eSpark-Backup/brianperi-smartwatch/Documents/Client-Files/Concept-Image.JPG

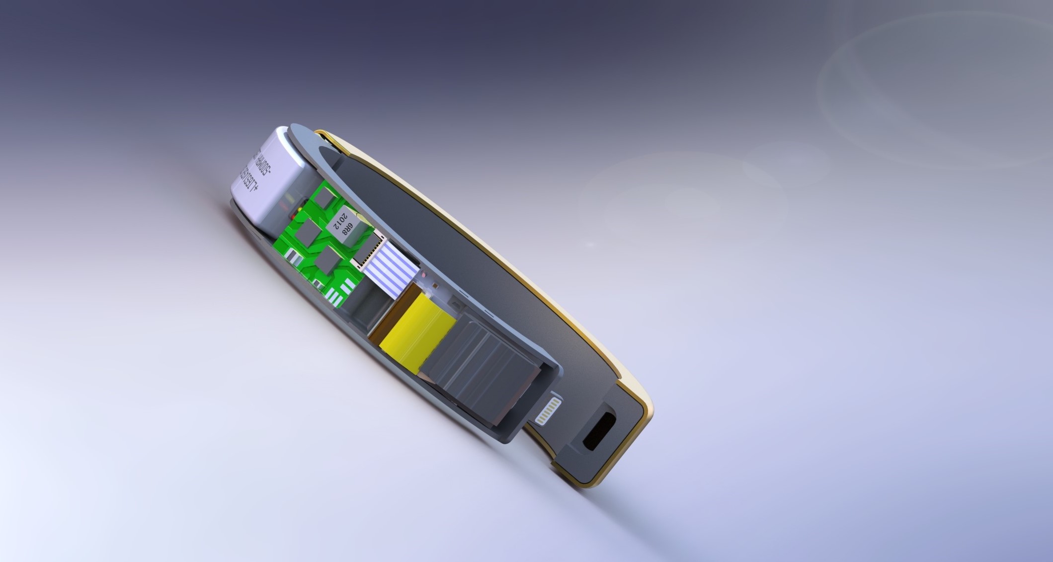
Documents/Client-Files/Concept-Image.JPG
