eSpark-Backup/brianperi-smartwatch/Documents/Client-Files/UPWORK-REQS/v1 pictures/edited/IMG_8461.jpg

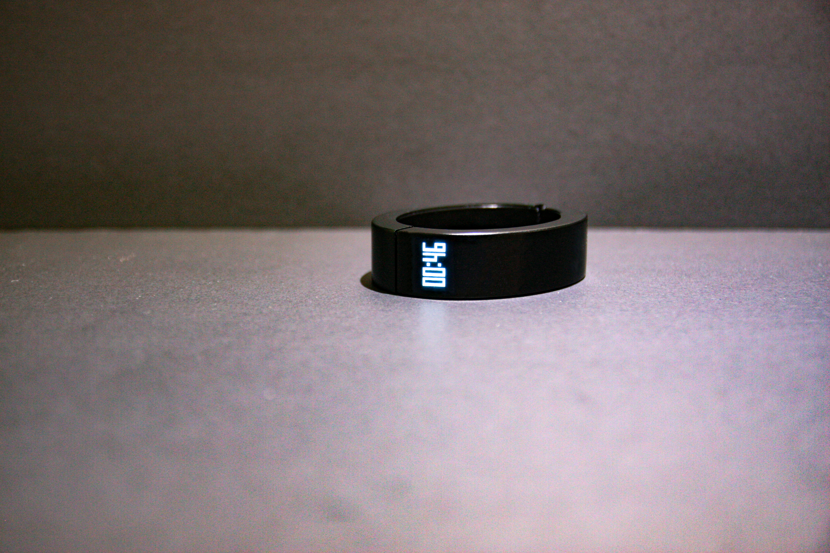
Documents/Client-Files/UPWORK-REQS/v1 pictures/edited/IMG_8461.jpg
