eSpark-Backup/brianperi-smartwatch/README.md

# BrianPeri-SmartWatch
 To enhance existing Smart Watch Design and to add support for BLE / WiFi Capability
