eSpark-Backup/brianperi-smartwatch/Design-Files/Bracelet(Aux_v2.0)/Bracelet_aux.PcbDoc.htm

Reporting Options

# File in Previous Format

Date | : | 7/9/2021
Time | : | 2:30:00 PM
Filename | : | D:\Github\BrianPeri-SmartWatch\Design-Files\Bracelet(Aux_v2.0)\_Design Files\Bracelet_aux.PcbDoc

Version | Warning

This file was generated by an earlier version of the software
