eSpark-Backup/brianperi-smartwatch/Design-Files/Bracelet(Aux_v2.0)/Bracelet_Aux_v2.0.PcbDoc.htm

Reporting Options

# File in Newer Format

Date | : | 7/10/2021
Time | : | 5:29:36 PM
Filename | : | E:\GitHub\BrianPeri-SmartWatch\Design-Files\Bracelet(Aux_v2.0)\_Design Files\Bracelet_Aux_v2.0.PcbDoc

Version | Warning
Release 20.0 | CAUTION - Support of propagation delay for primitives

This file was generated by a later version of the software
