eSpark-Backup/brianperi-smartwatch/Design-Files/Bracelet(Main)/Bracelet_Main.PcbDoc.htm

Reporting Options

# File in Newer Format

Date | : | 7/10/2021
Time | : | 11:03:33 AM
Filename | : | E:\GitHub\BrianPeri-SmartWatch\Design-Files\Bracelet(Main)\_Design Files\Bracelet_Main.PcbDoc

Version | Warning
Release 20.0 | CAUTION - Support of propagation delay for primitives

This file was generated by a later version of the software
