eSpark-Backup/brianperi-smartwatch/Documents/Client-Files/UPWORK-REQS/Concept Pitch2.pptx

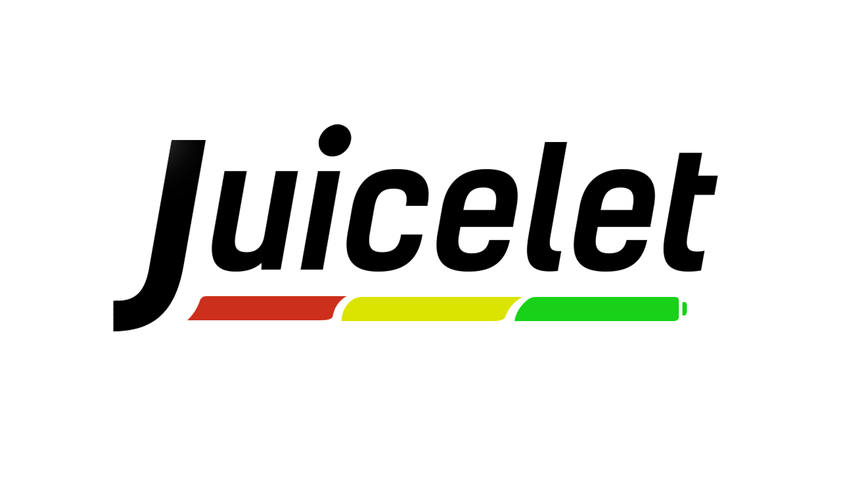
[picture p3: figure]

A whole new way to

c

har

ge.

## Slide 2

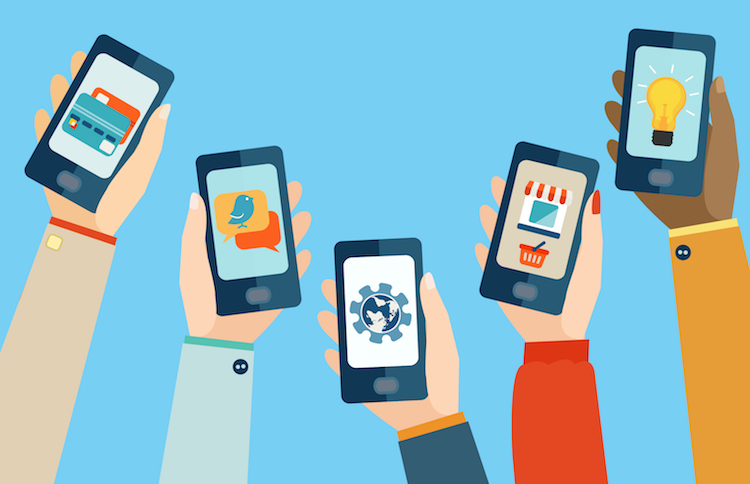
[picture p4: figure]

## Slide 3

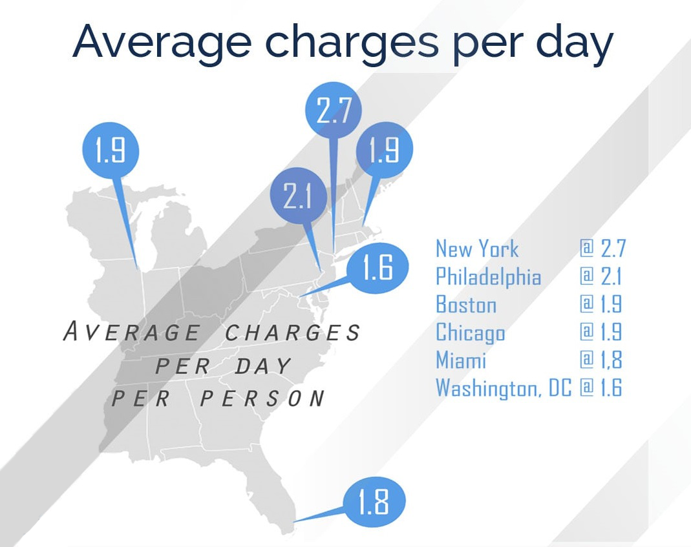
[picture p5: figure]

## 250 cycles

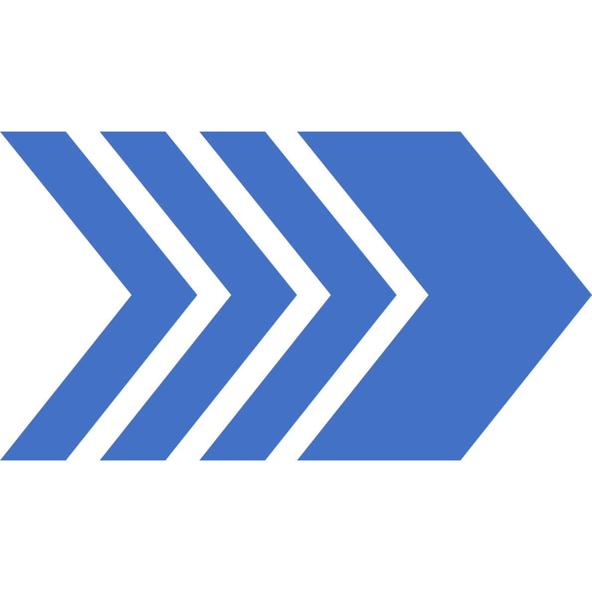
[picture p6: figure]

~73% battery

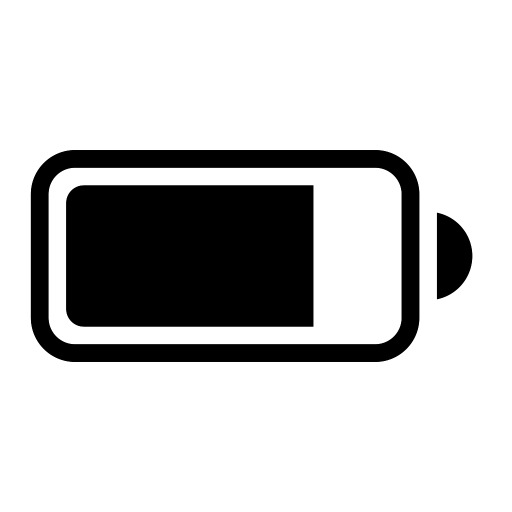
[picture p7: figure]

## Slide 5

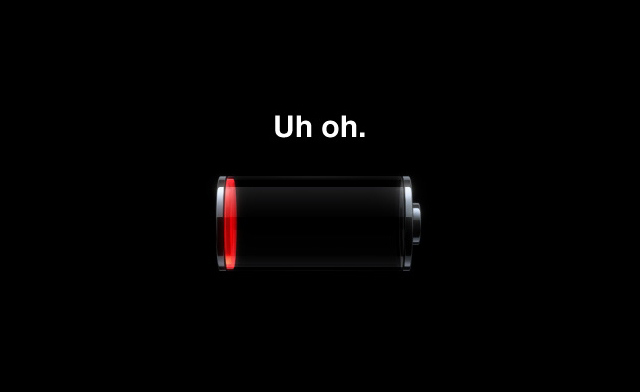
[picture p8: figure]

## Slide 6

Report low battery anxiety,
BUT

7.7 out of 10

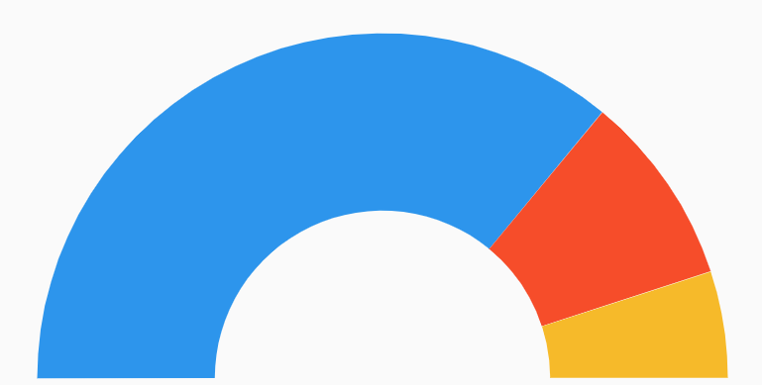
[picture p9: figure]

72%

Carry no backup

18%

Carry a charging cable

10%

Carry a portable charger

## Slide 7

The Problem?

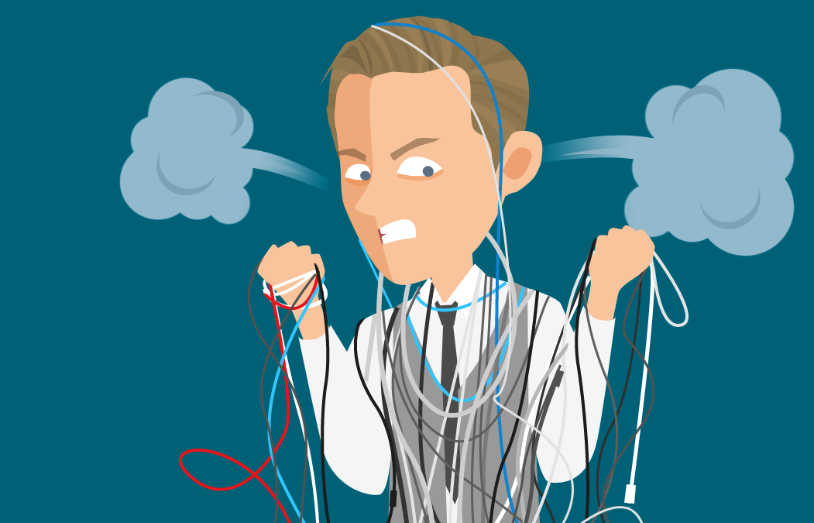
[picture p10: figure]
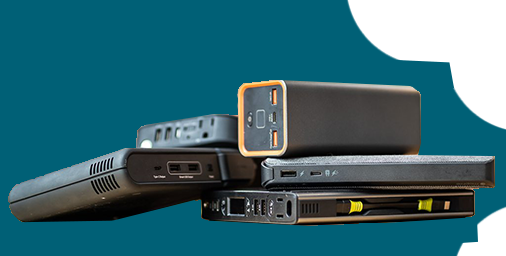
[picture p11: figure]

## Slide 8

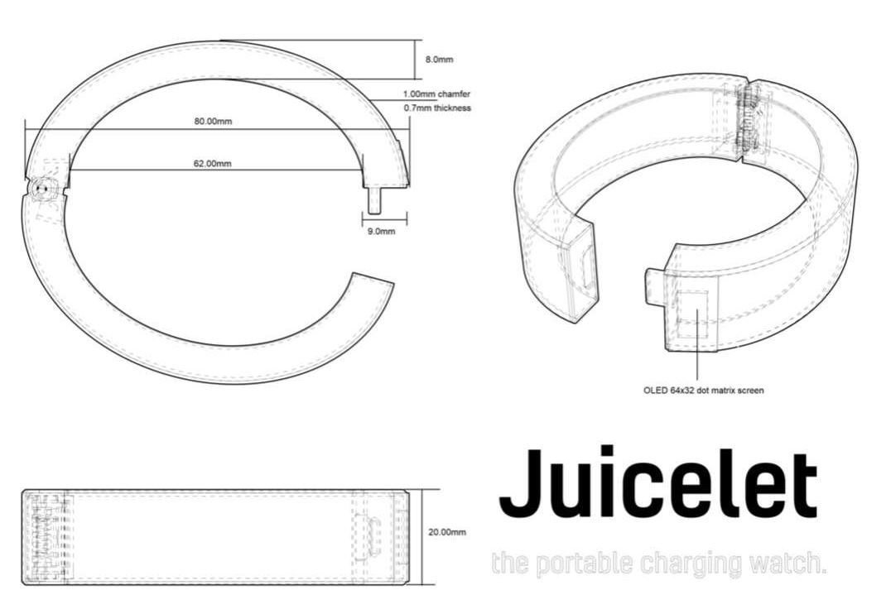
[picture p12: figure]

The worlds first-ever portable charging watch.

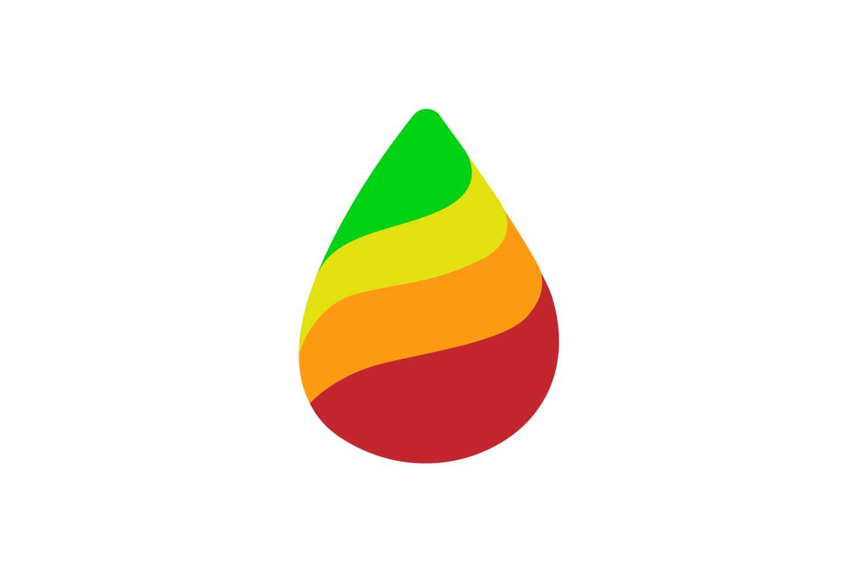
[picture p13: figure]
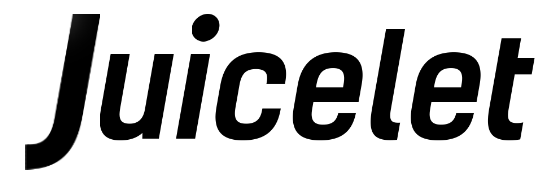
[picture p14: figure]

## Slide 9

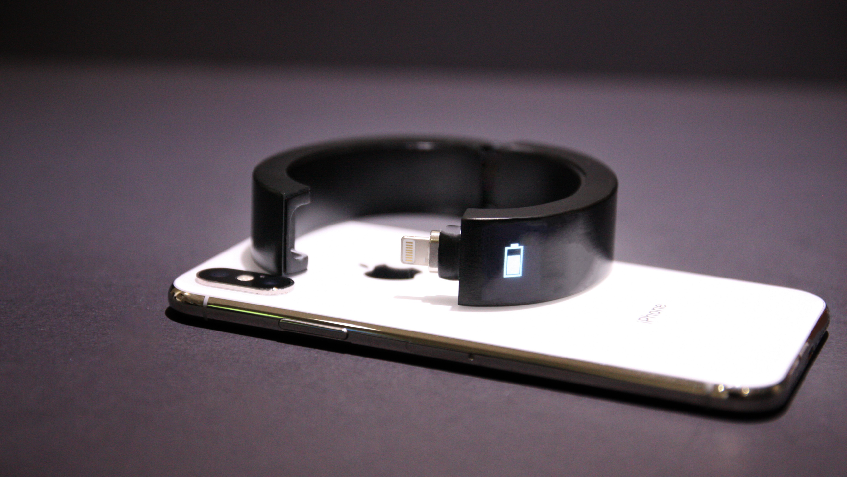
[picture p15: figure]

Simplicity meets functionality.

Full charge on over 80% of smartphones

## A new way to charge

Android/iPhone system

Graphene-enhanced battery

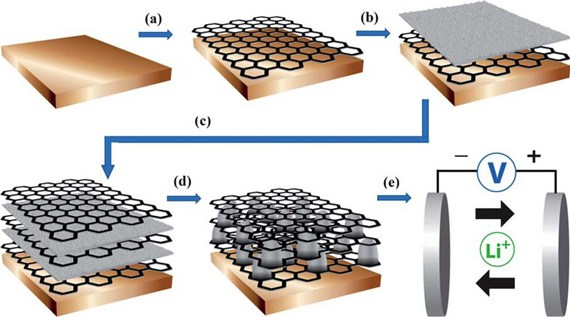
[picture p16: figure]
Image result for graphene battery

Smart OLED display

MEMS MicroSensors

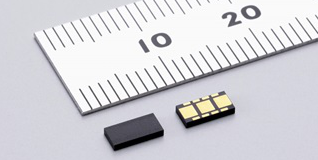
[picture p18: figure]
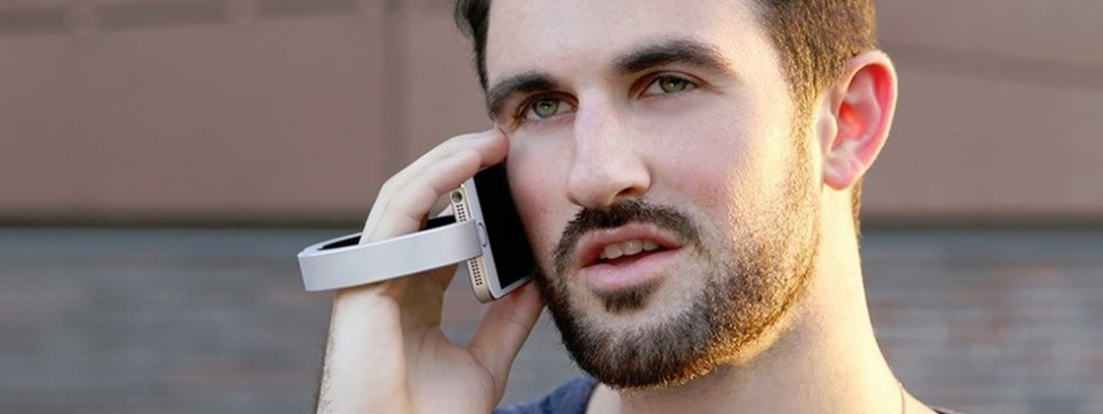
[picture p19: figure]

Ergonomic hinge design

## Slide 11

Brian Periku

Shahkir Alkozai

Liam Graham

Unmatched passion, talent, and industry skills

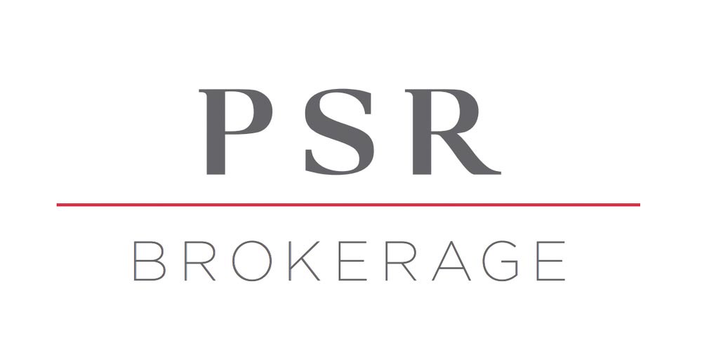
[picture p20: figure]
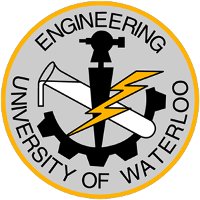
[picture p21: figure]
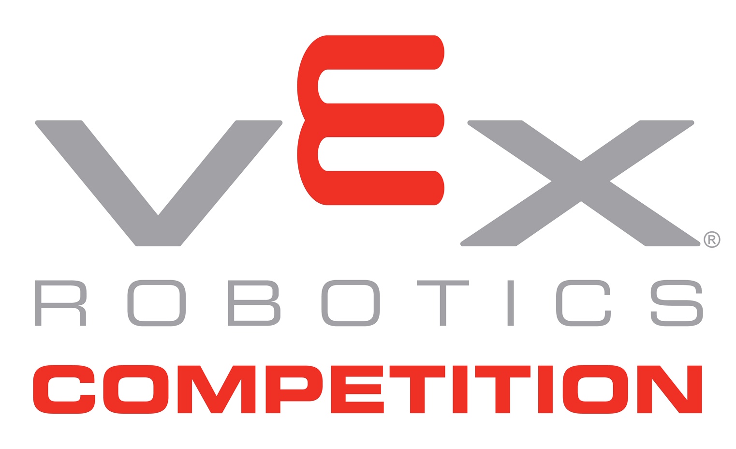
[picture p22: figure]
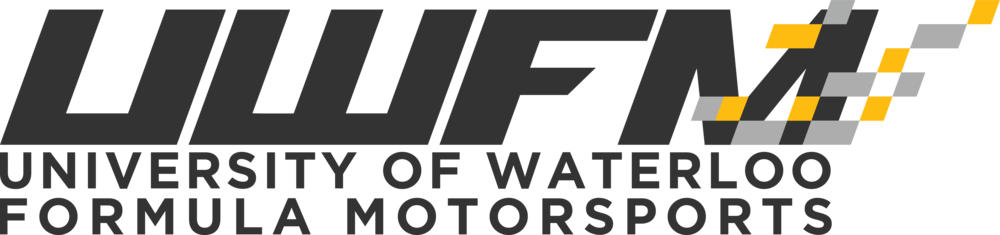
[picture p23: figure]
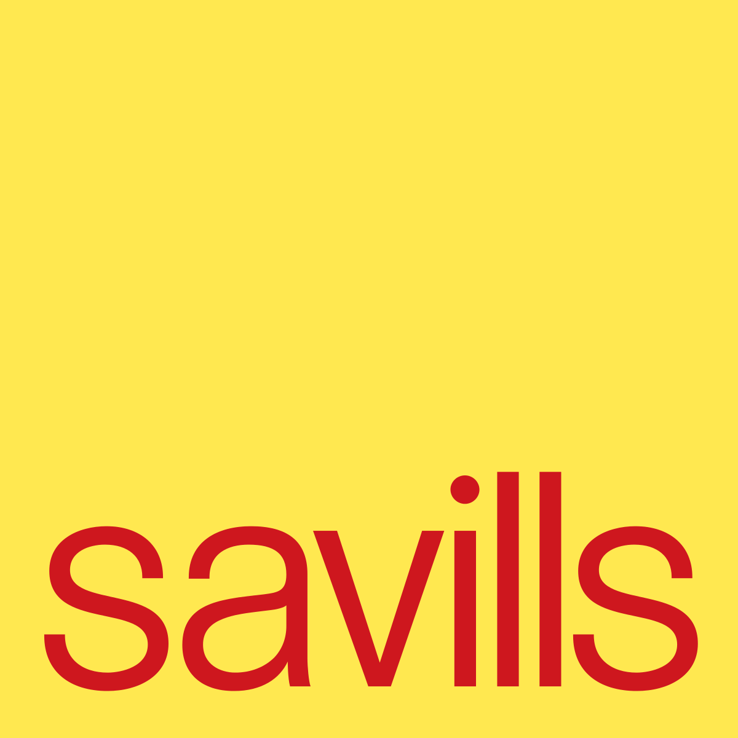
[picture p24: figure]
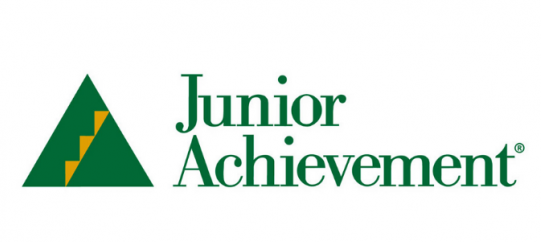
[picture p25: figure]
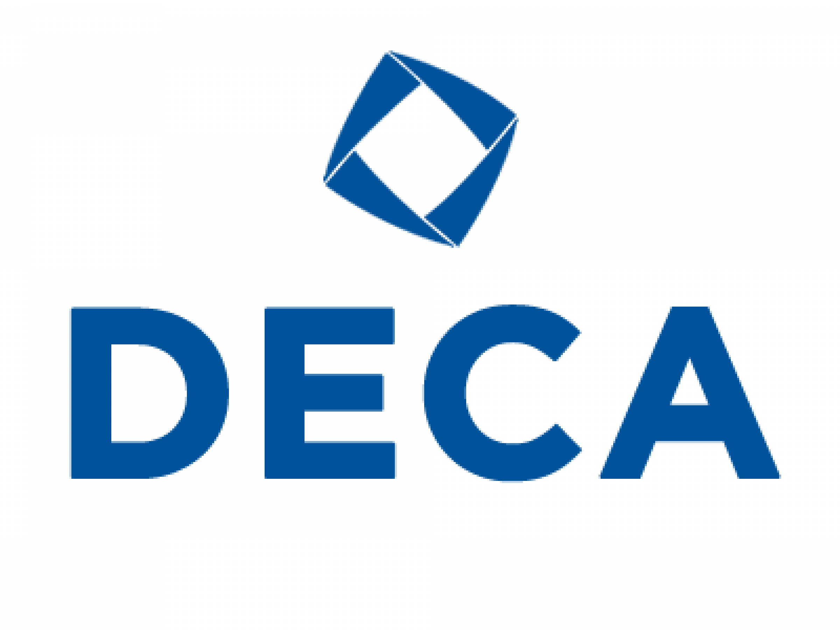
[picture p26: figure]
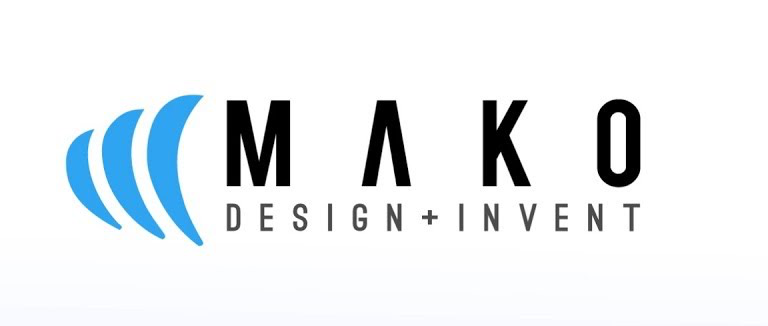
[picture p27: figure]

## Slide 12

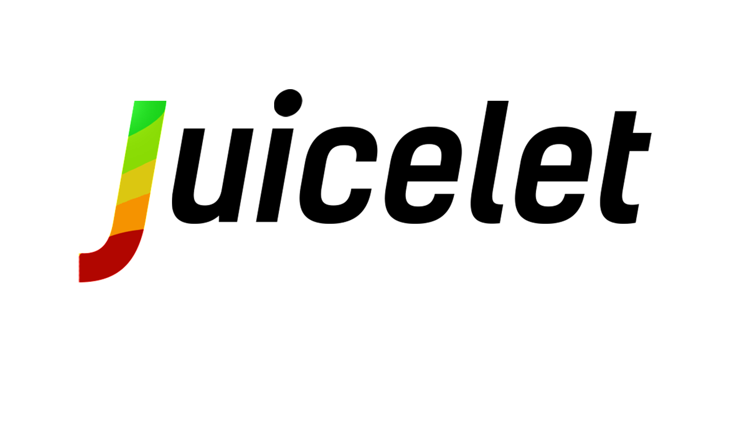
[picture p28: figure]

Redefining portable charging.
