eSpark-Backup/brianperi-smartwatch/Design-Files/Bracelet(Aux_v1.0)/Aux_PCB.PcbDoc.htm

Reporting Options

# File in Previous Format

Date | : | 7/9/2021
Time | : | 1:20:45 PM
Filename | : | D:\Github\BrianPeri-SmartWatch\Design-Files\Bracelet(Aux_v1.0)\_Design Files\Aux_PCB.PcbDoc

Version | Warning

This file was generated by an earlier version of the software
