eSpark-Backup/brianperi-smartwatch/Deliverables/Bracelet(Aux_v2.0)/Renderings/2D_Bottom_View.PNG

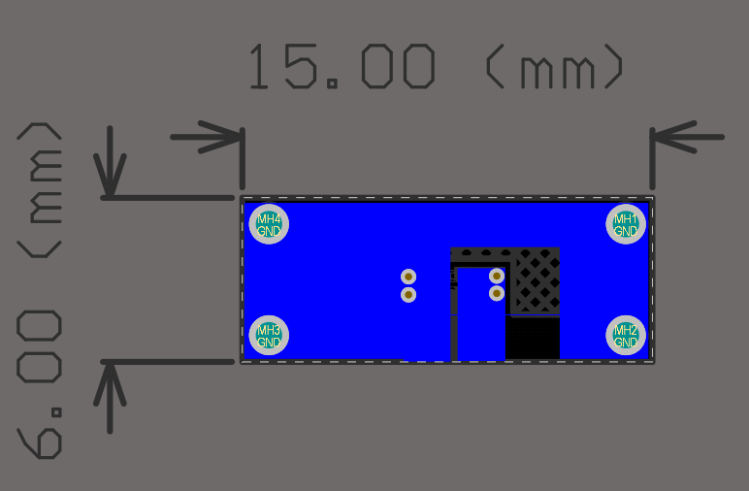
Deliverables/Bracelet(Aux_v2.0)/Renderings/2D_Bottom_View.PNG
