eSpark-Backup/brianperi-smartwatch/Deliverables/Bracelet(Aux_v2.0)/Renderings/3D_Top_View.PNG

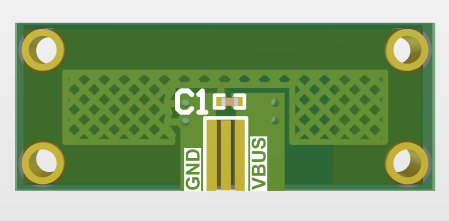
Deliverables/Bracelet(Aux_v2.0)/Renderings/3D_Top_View.PNG
