eSpark-Backup/brianperi-smartwatch/Deliverables/Bracelet(Main)/Renderings/2D_Bottom_Vew.PNG

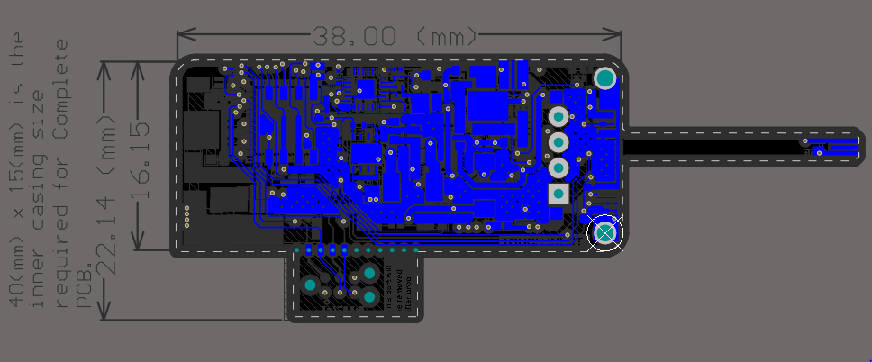
Deliverables/Bracelet(Main)/Renderings/2D_Bottom_Vew.PNG
