eSpark-Backup/brianperi-smartwatch/Deliverables/Bracelet(Main)/Renderings/2D_C_view.PNG

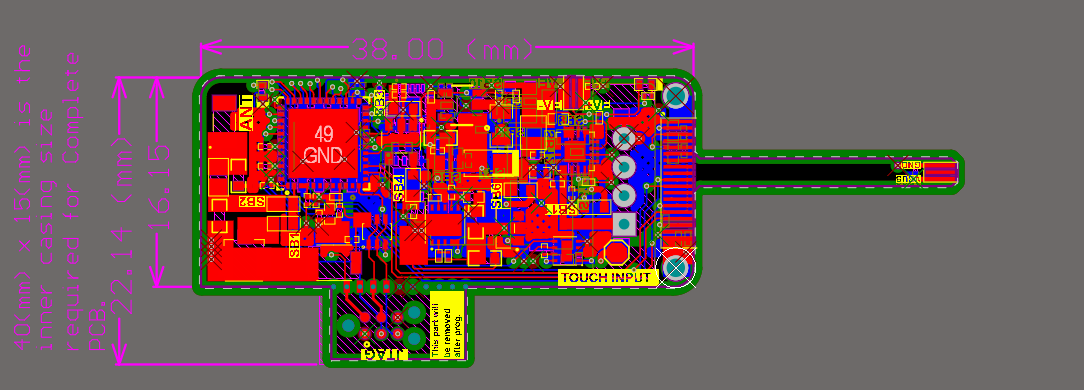
Deliverables/Bracelet(Main)/Renderings/2D_C_view.PNG
