eSpark-Backup/brianperi-smartwatch/Deliverables/Bracelet(Main)/Renderings/3D_Isometric_Vew.PNG

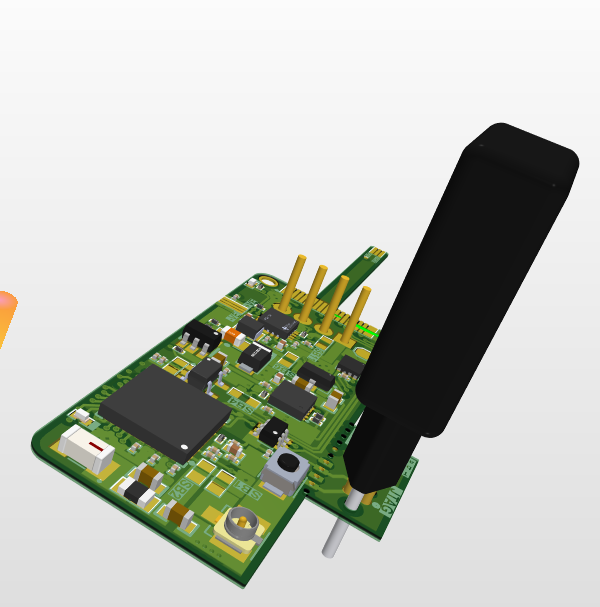
Deliverables/Bracelet(Main)/Renderings/3D_Isometric_Vew.PNG
