eSpark-Backup/brianperi-smartwatch/Deliverables/Bracelet(Main)/Renderings/3D_Top_Vew.PNG

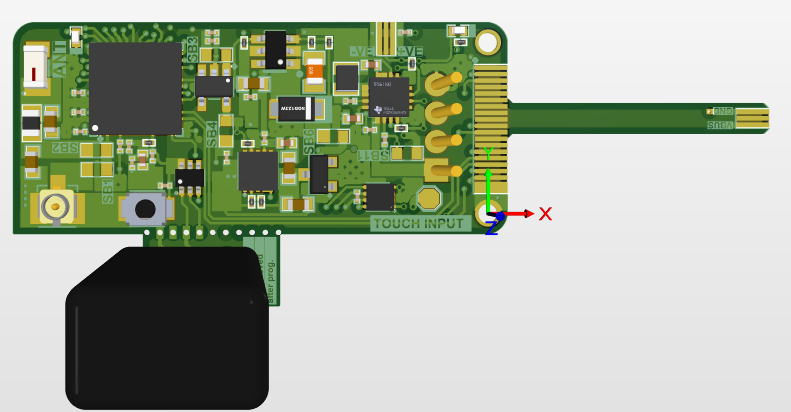
Deliverables/Bracelet(Main)/Renderings/3D_Top_Vew.PNG
