eSpark-Backup/brianperi-smartwatch/Documents/Client-Files/UPWORK-REQS/0.6'' RGB OLED/06-inch-Micro-Color-OLED-Display-Panel-RGB.jpg

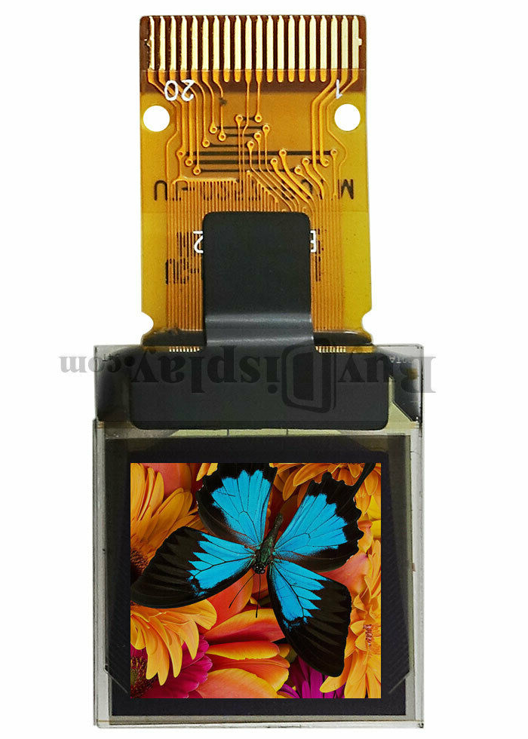
Documents/Client-Files/UPWORK-REQS/0.6'' RGB OLED/06-inch-Micro-Color-OLED-Display-Panel-RGB.jpg
