eSpark-Backup/brianperi-smartwatch/Documents/Client-Files/UPWORK-REQS/pcb p1bottom.png

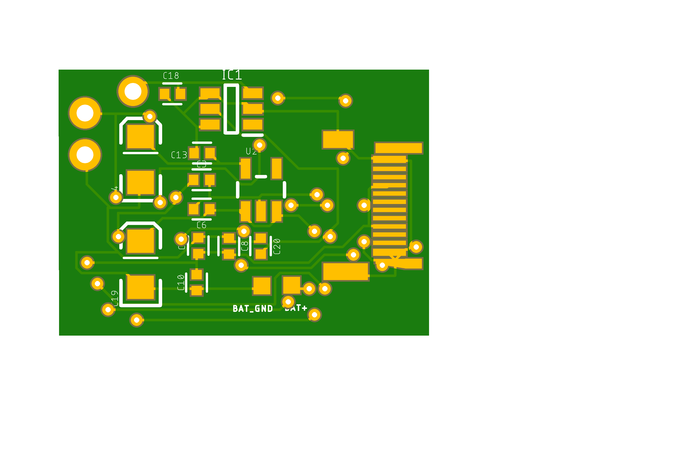
Documents/Client-Files/UPWORK-REQS/pcb p1bottom.png
