eSpark-Backup/brianperi-smartwatch/Documents/Client-Files/UPWORK-REQS/pcb p2 bottom.png

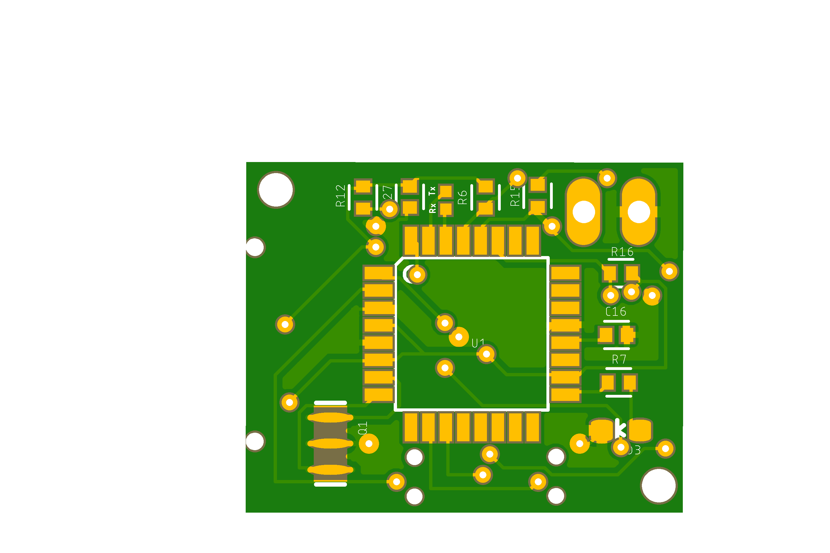
Documents/Client-Files/UPWORK-REQS/pcb p2 bottom.png
