eSpark-Backup/brianperi-smartwatch/Documents/Client-Files/UPWORK-REQS/pcbp1top.png

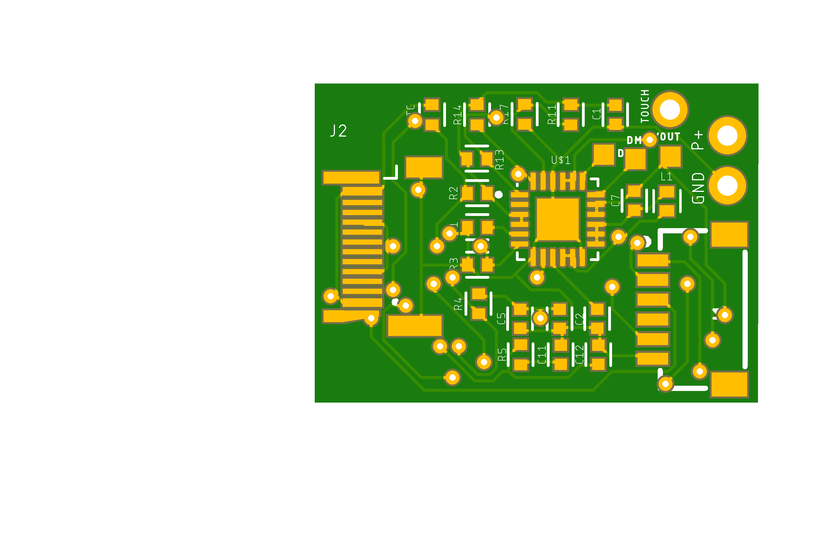
Documents/Client-Files/UPWORK-REQS/pcbp1top.png
