eSpark-Backup/brianperi-smartwatch/Documents/Client-Files/UPWORK-REQS/pcbp2top.png

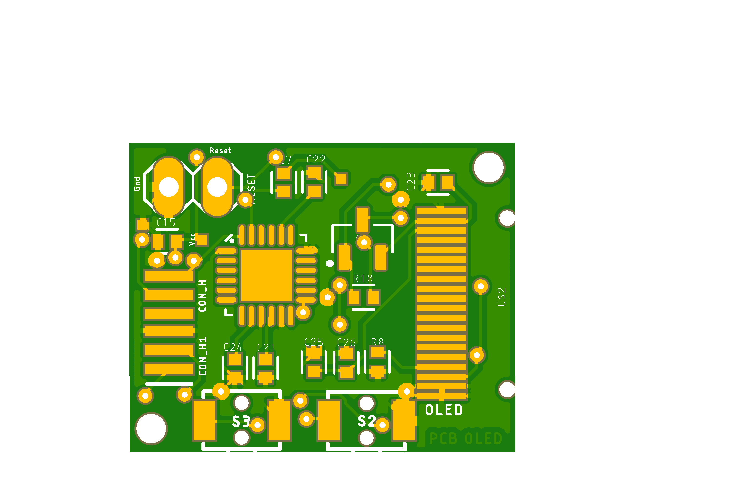
Documents/Client-Files/UPWORK-REQS/pcbp2top.png
