eSpark-Backup/brianperi-smartwatch/Documents/Client-Files/UPWORK-REQS/prod_des_gif.gif

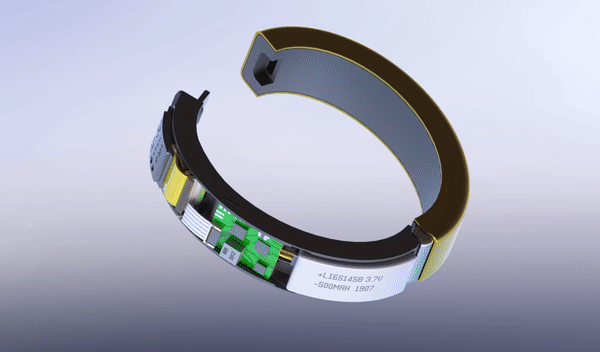
Documents/Client-Files/UPWORK-REQS/prod_des_gif.gif
