eSpark-Backup/brianperi-smartwatch/Documents/Client-Files/UPWORK-REQS/v1 pictures/edited/bracelet on box.jpg

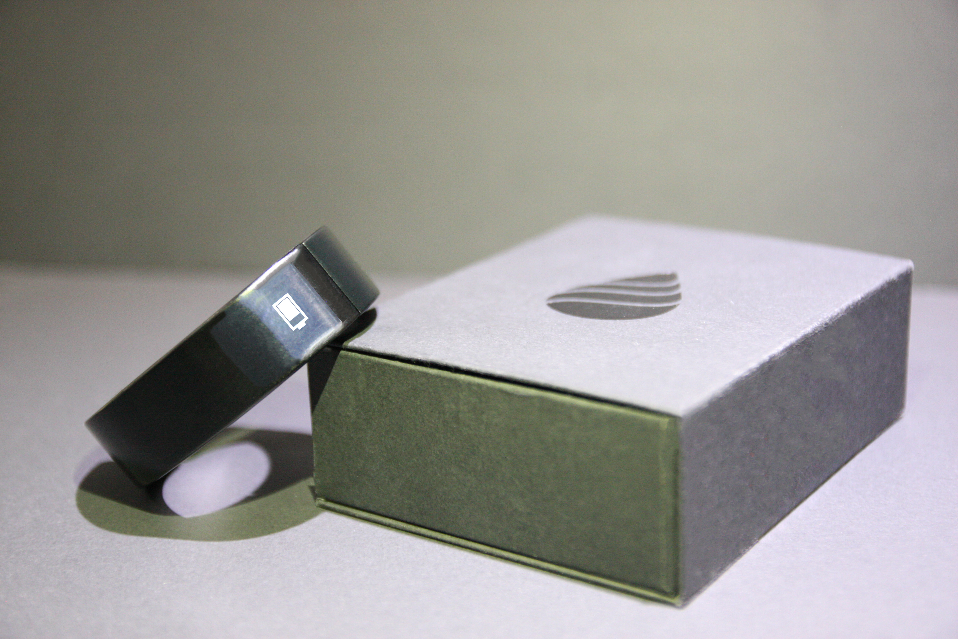
Documents/Client-Files/UPWORK-REQS/v1 pictures/edited/bracelet on box.jpg
