eSpark-Backup/brianperi-smartwatch/Documents/Client-Files/UPWORK-REQS/v1 pictures/edited/IMG_8396.jpg

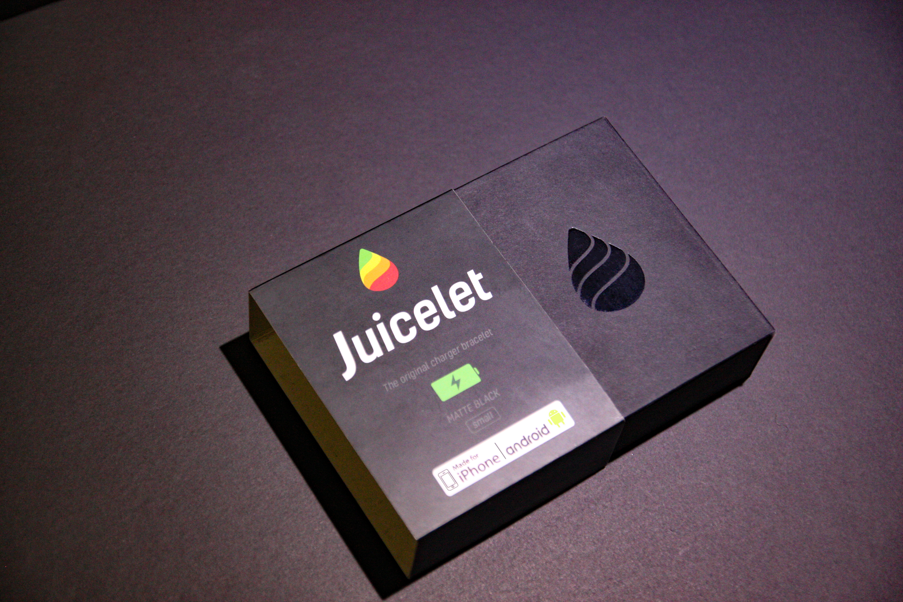
Documents/Client-Files/UPWORK-REQS/v1 pictures/edited/IMG_8396.jpg
