eSpark-Backup/brianperi-smartwatch/Deliverables/Bracelet(Main)/BOM/Bracelet_Main PCB-(LSCS).xlsx

Bill of Material (BOM) for Brian Peri
S. No. | Components | Description | Designator | Footprint (Package) | Manufacturer Part Number | Manufacturer | LCSC Part No | Alternate | Value | LCSC/MOQ | Quantity (Per Board) | Quantity (5 boards) | LCSC Link | Unit Cost(1) | Total Cost(1) | Unit Cost (5 Boards) | Total Cost (5) | Remarks
1 | Capacitor | CAP CER 0.1UF 25V X5R 0201 | C1, C2, C3, C4, C5, C6, C9, C13, C14, C15, C16, C17, C18, C21, C22, C23, C27, C33, C35, C41, C42, C45, C48, CU1 | CAP 0201 | GRM033R61E104KE14D | Murata Electronics | C76939 | ------------------- | 0.1uF | 150 | 24 | 120 | LCSC (https://lcsc.com/product-detail/Multilayer-Ceramic-Capacitors-MLCC-SMD-SMT_Murata-Electronics-GRM033R61E104KE14D_C76939.html) | $0.006 | $0.144 | $0.006 | $0.90
2 |  | CAP CER 2PF 50V C0G/NP0 0603 | C7 | Cap0603 | CML0603C0G2R0CT50V | Stackpole Electronics Inc | C1650 | ------------------- | 2pF | 50 | 1 | 5 | LCSC (https://lcsc.com/product-detail/Multilayer-Ceramic-Capacitors-MLCC-SMD-SMT_FH-Guangdong-Fenghua-Advanced-Tech-0603CG2R0C500NT_C1650.html) | $0.004 | $0.004 | $0.004 | $0.19
3 |  | CAP CER 2.7PF 50V C0G/NP0 0603 | C8 | Cap0603 | CML0603C0G2R7CT50V | Stackpole Electronics Inc | C95180 | ------------------- | 2.7pF | 50 | 1 | 5 | LCSC (https://lcsc.com/product-detail/Multilayer-Ceramic-Capacitors-MLCC-SMD-SMT_FH-Guangdong-Fenghua-Advanced-Tech-0603CG2R7C500NT_C95180.html) | $0.004 | $0.004 | $0.004 | $0.18
4 |  | CAP CER 10UF 10V X5R 0402 | C10, C19, C24, C29, C39, C40 | Cap 0402 | GRM155R61A106ME44D | Murata Electronics (https://lcsc.com/brand-detail/79.html) | C77000 | ------------------- | 10uF | 40 | 6 | 30 | LCSC (https://lcsc.com/product-detail/Multilayer-Ceramic-Capacitors-MLCC-SMD-SMT_Murata-Electronics-GRM155R61A106ME44D_C77000.html) | $0.027 | $0.164 | $0.027 | $1.09
5 |  | CAP CER 1UF 16V X5R 0201 | C11, C12, C20, C28, CU2 | CAP 0201 | CL03A105MO3NRNC | Samsung Electro-Mechanics | C318540 | CL03A105MO3NRNH | 1uF | 30 | 5 | 25 | LCSC (https://lcsc.com/product-detail/Multilayer-Ceramic-Capacitors-MLCC-SMD-SMT_Samsung-Electro-Mechanics-CL03A105MO3NRNC_C318540.html) | $0.049 | $0.245 | $0.049 | $1.47
6 |  | CAP CER 22UF 16V X5R 0805 | C25 | Cap0805 | CL21A226MOQNNNE | Samsung Electro-Mechanics | C98190 | ------------------- | 22uF | 10 | 1 | 5 | LCSC (https://lcsc.com/product-detail/Multilayer-Ceramic-Capacitors-MLCC-SMD-SMT_Samsung-Electro-Mechanics-CL21A226MOQNNNE_C98190.html) | $0.041 | $0.041 | $0.041 | $0.41
7 |  | CAP CER 22UF 10V X5R 0603 | C26, C30, C31 | Cap0603 | GRT188R61A226ME13D | Murata Electronics | C86295 | CL10A226MP8NUNE | 22uF | 20 | 3 | 15 | LCSC (https://lcsc.com/product-detail/Multilayer-Ceramic-Capacitors-MLCC-SMD-SMT_Samsung-Electro-Mechanics-CL10A226MP8NUNE_C86295.html) | $0.025 | $0.075 | $0.025 | $0.50
8 |  | CAP CER 4.7UF 16V X5R 0402 | C32, C34, C46, C47 | Cap 0402 | CL05A475MO5NUNC | Samsung Electro-Mechanics | C318563 | ------------------- | 4.7uF | 30 | 4 | 20 | LCSC (https://lcsc.com/product-detail/Multilayer-Ceramic-Capacitors-MLCC-SMD-SMT_Samsung-Electro-Mechanics-CL05A475MO5NUNC_C318563.html) | $0.072 | $0.287 | $0.072 | $2.15
9 |  | CAP CER 2.2UF 10V X5R 0201 | C36, C38 | CAP 0201 | GRM033R61A225ME47D | Murata Electronics (https://www.digikey.com/en/supplier-centers/murata-electronics) | C319184 | ------------------- | 2.2uF | 20 | 2 | 10 | LCSC (https://lcsc.com/product-detail/Multilayer-Ceramic-Capacitors-MLCC-SMD-SMT_Murata-Electronics-GRM033R61A225ME47D_C319184.html) | $0.027 | $0.054 | $0.027 | $0.54
10 |  | CAP SMD .047uF 16V 0201 | C37 | CAP 0201 | GRM033R61C473KE84D | Murata Electronics (https://www.digikey.com/en/supplier-centers/murata-electronics) | C88917 | ------------------- | 47nF | 50 | 1 | 5 | LCSC (https://lcsc.com/product-detail/Multilayer-Ceramic-Capacitors-MLCC-SMD-SMT_Murata-Electronics-GRM033R61C473KE84D_C88917.html) | $0.007 | $0.007 | $0.007 | $0.34
11 | Diode | DIODE SCHOTTKY 30V 1A SOD123W | D1 | SOD123W | PMEG3010ER,115 | Nexperia USA Inc. | ----------- | ------------------- | ---- | 10 | 1 | 5 | TME (https://www.tme.eu/en/details/pmeg3010er.115/smd-schottky-diodes/nexperia/) | $0.166 | $0.166 | $0.166 | $1.66 | NON stock in LCSC
12 |  | DIODE SCHOTTKY 20V 1A TO236AB | D2 | TO-236AB | PMEG2010ET,215 | Nexperia USA Inc. | C282564 | ------------------- | ----- | 7 | 1 | 5 | LCSC (https://lcsc.com/product-detail/Schottky-Barrier-Diodes-SBD_Nexperia-PMEG2010ET-215_C282564.html) | $0.182 | $0.182 | $0.182 | $1.28
13 |  | TOP VIEW / 0402 / 1.0X0.5X0.4 | LED1, LED2 | LED 0402 | 16-213/GHC-YR1S1/3T | Everlight Elec | C74338 | ------------------- | ----- | 20 | 2 | 10 | LCSC (https://lcsc.com/product-detail/Light-Emitting-Diodes-LED_Everlight-Elec-16-213-GHC-YR1S1-3T_C74338.html) | $0.076 | $0.152 | $0.076 | $1.52
14 | Inductor | FIXED IND 2.7NH 800MA 80MOHM SMD | L1 | Custom | L-15W2N7SV4E | Johanson Technology Inc. | C98530 | B82498F3279K000 | 2.7nH | 10 | 1 | 5 | LCSC (https://lcsc.com/product-detail/Inductors-SMD_FH-BK-Guangdong-Fenghua-Bangke-Elec-BKW0805UC2N7JGT_C98530.html) | $0.053 | $0.053 | $0.053 | $0.53 | Some Parameters are different
15 |  | 10uH ±20% 1.6A 230mO SMD Inductors | L2 | Custom | MS0420-100M | COILMX (https://lcsc.com/brand-detail/11934.html) | C380158 | ------------------- | 10uH | 7 | 1 | 5 | LCSC (https://lcsc.com/product-detail/Power-Inductors_COILMX-MS0420-100M_C380158.html) | $0.276 | $0.276 | $0.276 | $1.93
16 |  | FIXED IND 4.7UH 5A 52 MOHM SMD | L3 | Custom | AMDLA4530Q-4R7MT | Abracon LLC | ------------ | ------------------- | 4.7uH | 10 | 1 | 5 | China | $1.500 | $1.500 | $1.500 | $15.00 | Ye amount local supplier ki ha
17 |  | FIXED IND 1UH 2.7A 57 MOHM SMD | L4 | IND 0806 | DFE201610E-1R0M=P2 | Murata Electronics | C161082 | ------------------- | 1uH | 10 | 1 | 5 | LCSC (https://lcsc.com/product-detail/Inductors-SMD_Murata-Electronics_DFE201610E-1R0M-P2_Murata-Electronics-DFE201610E-1R0M-P2_C161082.html) | $0.117 | $0.117 | $0.117 | $1.17
18 | Mosfet | TRANS 2NPN PREBIAS 0.15W UMT6 | Q1 | SOT-363 | UMH3NTN | Rohm Semiconductor | C123008 | ------------------- | ----- | 10 | 1 | 5 | LCSC (https://lcsc.com/product-detail/Digital-Transistors_ROHM-Semicon-UMH3NTN_C123008.html) | $0.073 | $0.073 | $0.073 | $0.73 | less stock
19 |  | MOSFET N-CH 100V .1A SOT23-3 | Q2 | SOT-23 | ZVN3310FTA | Diodes Incorporated | C110533 | ------------------- | ----- | 7 | 1 | 5 | LCSC (https://lcsc.com/product-detail/MOSFETs_Diodes-Incorporated-ZVN3310FTA_C110533.html) | $0.413 | $0.413 | $0.413 | $2.89
20 | Resistor | RES 10K OHM 1% 1/20W 0201 | R1, R3, R4, R5, R6, R10 | Res-0201 | CR0201F10K0Q15Z | Ever Ohms Tech (https://lcsc.com/brand-detail/512.html) | C881217 | ------------------- | 10K | 100 | 6 | 30 | LCSC (https://lcsc.com/product-detail/Chip-Resistor-Surface-Mount_Ever-Ohms-Tech-CR0201F10K0Q15Z_C881217.html) | $0.002 | $0.013 | $0.002 | $0.21
21 |  | RES SMD 1.2K OHM 1% 1/20W 0201 | R2 | Res-0201 | AC0201JR-071K2L | Yageo | C144824 | ------------------- | 1.2K | 50 | 1 | 5 | LCSC (https://lcsc.com/product-detail/Chip-Resistor-Surface-Mount_YAGEO-AC0201JR-071K2L_C144824.html) | $0.012 | $0.012 | $0.012 | $0.58
22 |  | RES SMD 47K OHM 1% 1/20W 0201 | R7 | Res-0201 | RC0201FR-0747KL | Yageo | C138139 | ------------------ | 47K | 100 | 1 | 5 | LCSC (https://lcsc.com/product-detail/Chip-Resistor-Surface-Mount_YAGEO-RC0201FR-0747KL_C138139.html) | $0.002 | $0.002 | $0.002 | $0.16
23 |  | RES SMD 1.4M OHM 1% 1/20W 0201 | R8 | Res-0201 | 0201WMF1404TEE | UNI-ROYAL(Uniroyal Elec) (https://lcsc.com/brand-detail/99.html) | C423737 | ------------------ | 1.4M | 100 | 1 | 5 | LCSC (https://lcsc.com/product-detail/Chip-Resistor-Surface-Mount_UNI-ROYAL-Uniroyal-Elec-0201WMF1404TEE_C423737.html) | $0.003 | $0.003 | $0.003 | $0.33
24 |  | RES SMD 71.5K OHM 1% 1/20W 0201 | R9 | Res-0201 | 0201WMF7152TEE | UNI-ROYAL(Uniroyal Elec) (https://lcsc.com/brand-detail/99.html) | C516473 | ------------------ | 71.5K | 100 | 1 | 5 | LCSC (https://lcsc.com/product-detail/Chip-Resistor-Surface-Mount_UNI-ROYAL-Uniroyal-Elec-0201WMF7152TEE_C516473.html) | $0.001 | $0.001 | $0.001 | $0.10
25 |  | Res 95.3K Ohm 1% 1/20W 0201 | R11 | Res-0201 | WR02X9532FAL | Walsin Technology Corporation | C270678 | 0201WMF9532TCE | 95.3K | 100 | 1 | 5 | LCSC (https://lcsc.com/product-detail/Chip-Resistor-Surface-Mount_UNI-ROYAL-Uniroyal-Elec-0201WMF9532TCE_C270678.html) | $0.001 | $0.001 | $0.001 | $0.10
26 |  | RES 13K OHM 1% 1/20W 0201 | R12 | Res-0201 | 0201WMJ0133TEE | UNI-ROYAL(Uniroyal Elec) (https://lcsc.com/brand-detail/99.html) | C423382 | ------------------ | 13K | 100 | 1 | 5 | LCSC (https://lcsc.com/product-detail/Chip-Resistor-Surface-Mount_UNI-ROYAL-Uniroyal-Elec-0201WMJ0133TEE_C423382.html) | $0.001 | $0.001 | $0.001 | $0.10
27 |  | RES 1M OHM 5% 1/20W 0201 | R13, R16 | Res-0201 | WR02X105JAL | Walsin Technology Corporation | C384434 | ------------------ | 1M | 100 | 2 | 10 | LCSC (https://lcsc.com/product-detail/Chip-Resistor-Surface-Mount_Walsin-Tech-Corp-WR02X105JAL_C384434.html) | $0.001 | $0.002 | $0.001 | $0.12
28 |  | RES SMD 1K OHM 1% 1/20W 0201 | R14 | Res-0201 | RC0201FR-071KL | Yageo | C138165 | ------------------ | 1K | 100 | 1 | 5 | LCSC (https://lcsc.com/product-detail/Chip-Resistor-Surface-Mount_YAGEO-RC0201FR-071KL_C138165.html) | $0.001 | $0.001 | $0.001 | $0.11
29 |  | RES SMD 13.3K 1/20W 0201 | R15 | Res-0201 | 0201WMF1332TEE | UNI-ROYAL(Uniroyal Elec) (https://lcsc.com/brand-detail/99.html) | C423749 | ------------------ | 13.3K | 100 | 1 | 5 | LCSC (https://lcsc.com/product-detail/Chip-Resistor-Surface-Mount_UNI-ROYAL-Uniroyal-Elec-0201WMF1332TEE_C423749.html) | $0.001 | $0.001 | $0.001 | $0.13
30 |  | THERMISTOR NTC 10KOHM 3380K 0201 | R17 | Res-0201 | NCP03XH103F05RL | Murata Electronics (https://www.digikey.com/en/supplier-centers/murata-electronics) | C98098 | ------------------ | 10K | 20 | 1 | 5 | LCSC (https://lcsc.com/product-detail/NTC-Thermistors_Murata-Electronics-NCP03XH103F05RL_C98098.html) | $0.023 | $0.023 | $0.023 | $0.45
31 |  | Res SMD 21K Ohm 1% 1/20W 0201 | R18 | Res-0201 | AC0201FR-0721KL | Yageo | C910620 | ------------------ | 21K | 100 | 1 | 5 | LCSC (https://lcsc.com/product-detail/Chip-Resistor-Surface-Mount_YAGEO-AC0201FR-0721KL_C910620.html) | $0.002 | $0.002 | $0.002 | $0.17
32 |  | RES SMD 4.32K OHM 1% 1/20W 0201 | R19 | Res-0201 | RK73H1HTTC4321F | KOA Speer Electronics, Inc. | C369015 | ------------------ | 4.32K | 50 | 1 | 5 | LCSC (https://lcsc.com/product-detail/Chip-Resistor-Surface-Mount_KOA-Speer-Elec-RK73H1HTTC4321F_C369015.html) | $0.008 | $0.008 | $0.008 | $0.40
33 | Switch | SWITCH TACTILE SPST-NO 0.05A 12V | SW1 | Custom | B3U-1000P | Omron Electronics Inc-EMC Div | C231329 | ---------------- | ----- | 7 | 1 | 5 | LCSC (https://lcsc.com/product-detail/Tactile-Switches_Omron-Electronics-B3U-1000P_C231329.html) | $0.476 | $0.476 | $0.476 | $3.33
34 | Antenna | RF ANT 2.4GHZ CHIP SOLDER SMD | U | Custom | 2450AT18A100E | Johanson Technology Inc. |  | --------------- | ----- | 85 | 1 | 5 | WinSource (https://www.win-source.net/rf-antennas-2450at18a100e.html) | $0.597 | $0.597 | $0.597 | $50.74 | Amount issue need quoat to local supplier
35 | Ics | RX TXRX MOD WIFI SURFACE MOUNT | U2 | Custom | ESP32-PICO-D4 | Espressif Systems | C193707 | --------------- | ----- | 6 | 1 | 5 | LCSC (https://lcsc.com/product-detail/RF-Transceiver-ICs_Espressif-Systems-ESP32-PICO-D4_C193707.html) | $3.372 | $3.372 | $3.372 | $20.23
36 |  | Volatile 64Mb (8M x 8) SPI/ QPI 2.7V ~ 3.6V SOP-8 | U3 | SOP-8 | LY68L6400SLIT | Lyontek Inc. (https://lcsc.com/brand-detail/11667.html) | C261881 | --------------- | ----- | 6 | 1 | 5 | LCSC (https://lcsc.com/product-detail/SRAM_Lyontek-Inc-LY68L6400SLIT_C261881.html) | $1.687 | $1.687 | $1.687 | $10.12
37 |  | WIDE-FULL SCALE RANGE 6-AXIS MEM | U4 | 24-QFN (3x3) | ICM-20649 | TDK InvenSense |  | --------------- | ----- | 5 | 1 | 5 | WinSource (https://www.win-source.net/tdk-corporation-icm-20649.html) | $16.577 | $16.577 | $16.577 | $82.89 | Amount issue need quoat to local supplier
38 |  | IC SENSR TOUCH/PROX 1CH 8-UDFN | U5 | 8-UDFN | AT42QT1011-MAHR | Microchip Technology |  | --------------- | ----- | 750 | 1 | 5 | Onlinecomponent (https://www.onlinecomponents.com/en/microchip-tech/at42qt1011mahr-49778133.html) | $0.496 | $0.496 | $0.496 | $372.00 | 250 stock but 750 moq Amount issue need quoat to local supplier
39 |  | 33V 4A DFN-10 DC-DC Converters RoHS | U6 | DFN-10 | SY7304DBC | Silergy Corp (https://lcsc.com/brand-detail/897.html) |  | --------------- | ----- | 22 | 1 | 5 | Chipmall (https://www.chipmall.com/product_detail/Silergy-Corp/Switching-Voltage-Regulators/SY7304DBC_4998319.html) | $0.728 | $0.728 | $0.728 | $16.01 | MOQ 22 Amount issue need quoat to local supplier
40 |  | Step-Up Positive Adjustable SOT-23-6 DC-DC Converters | U7 | SOT-23-6 | AX5523CA | Axelite Tech (https://lcsc.com/brand-detail/488.html) | C157694 | --------------- | ----- | 6 | 1 | 5 | LCSC (https://lcsc.com/product-detail/DC-DC-Converters_Axelite-Tech-AX5523CA_C157694.html) | $0.323 | $0.323 | $0.323 | $1.94
41 |  | IC PWR SWITCH P-CHAN 1:1 SOT23-5 | U8 | SOT-23-5 | MIC2004-0.5YM5-TR | Microchip Technology |  | --------------- | ----- | 10 | 1 | 5 |  |  | $0.000 |  | $0.00 | need quoat to local supplier
42 |  | IC REG LINEAR 3.3V 1A UDFN3030-8 | U9 | U-DFN3030-8 | AP7361C-33FGE-7 | Diodes Incorporated (https://lcsc.com/brand-detail/296.html) | C151007 | --------------- | ----- | 6 | 1 | 5 | LCSC (https://lcsc.com/product-detail/Linear-Voltage-Regulators-LDO_Diodes-Incorporated-AP7361C-33FGE-7_C151007.html) | $0.310 | $0.310 | $0.310 | $1.86
43 |  | STANDALONE 1-CELL 17-V, 3.0-A BA | U10 | 16-WQFN (3x3) | BQ25303JRTER | Texas Instruments |  | --------------- | ----- | 5 | 1 | 5 | LCSC (https://lcsc.com/search?q=BQ25303JRTER) | $1.725 | $1.725 | $1.725 | $8.62 | Available to backorder
44 | Connector | CONN U.FL RCPT STR 50 OHM SMD | J1 | Custom | U.FL-R-SMT-1(80) | Hirose Electric Co Ltd | C88374 | --------------- | ----- | 7 | 1 | 5 | LCSC (https://lcsc.com/product-detail/RF-Connectors-Coaxial-Connectors_HRS-Hirose-U-FL-R-SMT-1-80_C88374.html) | $0.091 | $0.091 | $0.091 | $0.64
45 |  | Straight 4 pin magnetic data connector high quality | J6 | Custom | HTP-CON-M411H | HYTEPRO (https://www.hyte.pro/) | ------------- | --------------- | ----- | 7 | 1 | 5 | Hytepro | $8.800 | $8.800 | $8.800 | $61.60 | Please Fill this
46 |  | CABLE ADAPTER 6 POS | J5 | Custom | TC2030-IDC | Tag-Connect LLC | ------------- | --------------- | ----- | ------- | 1 | 5 | ---------------- | ---------------- | ---------------- | ---------------- | ---------------- | DO NOT MOUNT
47 |  | CONN FPC 20POS 0.5MM SMD R/A | J2 | 20 Pin FPC | 20 Pin FPC | --------------- |  | --------------- | ----- |  | 1 | 5 | ---------------- | ---------------- | ---------------- | ---------------- | ---------------- | DO NOT MOUNT
48 |  | CONN FPC 3POS 0.5MM SMD R/A | J3, J4 | 3 Pin FPC | 3 Pin FPC | --------------- |  | --------------- | ----- |  | 2 | 10 | ---------------- | ---------------- | ---------------- | ---------------- | ---------------- | DO NOT MOUNT
49 |  | Test Point ON | P2 | TEST POINT | TEST POINT | --------------- |  | --------------- | ----- |  | 1 | 5 | ---------------- | ---------------- | ---------------- | ---------------- | ---------------- | DO NOT MOUNT
50 |  | Solder Bridge ON | SB1, SB2, SB3, SB4, SB5, SB6, SB7, SB8, SB9, SB10, SB11, SB12, SB13, SB14 | Solder Bridge | Solder Bridge | --------------- |  | --------------- | ----- |  | 14 | 70 | ---------------- | ---------------- | ---------------- | ---------------- | ---------------- | DO NOT MOUNT
51 | OLED | Display Module | OLED | Custom | UG-6464TDDBG01 | --------------- |  | --------------- | ----- |  | 1 | 3 |  |  |  |  |  | Quotation Send to supplier
52 | Battery |  |  | Custom |  | --------------- |  | --------------- |  |  |  |  |  |  |  |  |  | Ask to the Cient
 |  |  |  |  |  |  |  |  | Total Component Cost |  |  |  |  |  |  |  | $667.44
 |  |  |  |  |  |  |  |  | Single Board Cost |  |  |  |  |  | $39.21 |  | $133.49
