eSpark-Backup/brianperi-smartwatch/Deliverables/Bracelet(Aux_v2.0)/BOM/Bracelet_Aux_v2.0(LCSC).xlsx

Bill of Material (BOM) for Brian Peri
S. No. | Components | Description | Designator | Footprint (Package) | Manufacturer Part Number | Manufacturer | LCSC Part No | Alternate | Value | LCSC/MOQ | Quantity (Per Board) | Quantity (5 boards) | LCSC Link | Unit Cost(1) | Total Cost(1) | Unit Cost (5 Boards) | Total Cost (5) | Remarks
1 | Capacitor | Multilayer Ceramic Capacitors MLCC - SMD/SMT 0201 0.1uF 25volts X5R 10% | C1, C2 | CAP 0201 | GRM033R61E104KE14D | Murata | C76939 |  | 0.1uF | 50 | 2 | 10 | LCSC (https://lcsc.com/product-detail/Multilayer-Ceramic-Capacitors-MLCC-SMD-SMT_Murata-Electronics-GRM033R61E104KE14D_C76939.html) | $0.0060 | $0.01 | $0.0060 | $0.30
2 | Connector | CONN FPC 3POS 0.5MM SMD R/A | J1 | 3 Pin FPC | 3 Pin FPC |  |  |  | 3 Pin FPC |  | 1 | 5 | --------- | $0.00 | $0.00 | $0.00 | $0.00 | DO NOT MOUNT
3 |  | SMD PADS | J2 | SMD PAD | SMD PAD |  |  |  | SMD PADS |  | 1 | 5 | --------- | $0.00 | $0.00 | $0.00 | $0.00 | DO NOT MOUNT
 |  |  |  |  |  |  |  |  | Total Component Cost |  |  |  |  |  | $0.01 |  | $0.30
 |  |  |  |  |  |  |  |  | Single Board Cost
