eSpark-Backup/brianperi-smartwatch/Documents/Client-Files/UPWORK-REQS/Bracelet_PCB_v3 0_OK (1).xlsx

Sheet: COMP
Qty | Value | Package | Parts | Description | MF | MPN | Remark | REPLY 06/28
1 | CDBU0245CDBU-M | CDBU-M | D1 | CDBU0245-HF | Comchip | CDBU0245-HF
1 | 525590652 | 525590652 | J2 | FFC CABLE CONNECTOR | Molex | 525590652
2 | 10051922-1010ELF | FCI_10051922-1010ELF | J3, J4 | FFC/FPC CONNECTOR, 10POS, 1ROW | Amphenol ICC | 10051922-1010ELF
1 | 100nF | C0201 | C17 | CAPACITOR, European symbol | Samsung | CL03A104KO3NNNC
3 | 10K | R0201 | R10, R19, R22 | RESISTOR, American symbol
1 | 10K | R0201 | R23 | RESISTOR, American symbol | Panasonic | ERJ-1GNF1583C
1 | 10nF | C0201 | C4 | CAPACITOR, European symbol | Murata | GRM033R61E103MA12D
3 | 10uF | C0603 | C3, C7, C15 | CAPACITOR, European symbol | Murata | GRM188R61C106KAALJ
1 | 143K | R0201 | R8 | RESISTOR, American symbol
1 | 158K | R0201 | R13 | RESISTOR, American symbol | Panasonic | ERJ-1GNF1583C
1 | 18K | R0201 | R14 | RESISTOR, American symbol
1 | 1uF | C0402 | C5 | CAPACITOR, European symbol | Samsung | CL05A105KA5NQNC
1 | 1uF | DFE252012PD | L3 | FIXED IND 1UH 3.2A 42 MOHM SMD | Murata Electronics | DFE252012PD-1R0M=P2 | Model is inductance | OK 1uH
1 | 220uF | CT3528 | C8 | POLARIZED CAPACITOR, European symbol | AVX | F930J227MBA
1 | 22uF16V | C1206 | C11 | CAPACITOR, European symbol | YAGUEO | CC1206ZKY5V7BB226
2 | 3.3uH | 0603(1608) | L2, L4 | Inductor Power Chip Wirewound MCOIL MB Series | Taiyo Yuden | MBKK1608T3R3M
1 | 317R | R0201 | R6 | RESISTOR, American symbol
1 | 31K23 | R0201 | R12 | RESISTOR, American symbol |  |  | Haven't 31.23k, have 0201 30.9k and 31.6k,please check and confirm | 31.6K OK
1 | 390K | R0201 | R18 | RESISTOR, American symbol
2 | 3K3 | R0201 | R3, R4 | RESISTOR, American symbol
3 | 4.7uF | C0402 | C2, C6, C12 | CAPACITOR, European symbol | Samsung | CL05A475MO5NUNC
5 | 47K | R0201 | R1, R2, R5, R16, R17 | RESISTOR, American symbol
1 | 47nF | C0201 | C14 | CAPACITOR, European symbol | Murata | GRM033R61C473KE84D
1 | 501951-2010 | 5019512010 | J1 | MOLEX - 501951-2010. - CONNECTOR, FPC, RCPT, 20POS, 2ROW |  | 501951-2010 | Chinese Brand | OK
1 | 5K25 | R0201 | R11 | RESISTOR, American symbol |  |  | Haven't 5.25k, have 0201 5.23k, please check and confirm | 5.23K OK
1 | 6.8uH | SRP5030 | L1 | BOURNS high saturation current Inductors | Bourns | SRP5030T-6R8M
1 | 68K | R0201 | R15 | RESISTOR, American symbol
1 | 68pF | C0201 | C1 | CAPACITOR, European symbol | Murata | GRM0335C1H680JA01D
1 | 750K | R0201 | R7 | RESISTOR, American symbol
1 | 820K | R0201 | R9 | RESISTOR, American symbol
1 | 820pF | C0201 | C16 | CAPACITOR, European symbol | Murata | CL03A104KO3NNNC
1 | AT42QT1011MAHR | 8-UDFN | U8 | Single Key capacitive touch controller | Microchip | AT42QT1011-MAHR
1 | ATMEGA328P-MU | QFN50P500X500X100-33N | U1 | Programmable Flash | Microchip | ATMEGA328P-MU
2 | B3U-3000P | SW_B3U-3000P | S1, S2 | Switch Tactile N.O. SPST Button Gull Wing 0.05A 12VDC 1.59N SMD Embossed T/R | Omron Electronics | B3U-3000P
1 | BQ24298RTWR | VQFN | U7 | The bq24298 is a highly-integrated switch-mode | Texas Instruments | BQ24298RTWR
1 | BSS138 | SOT23 | Q1 |  |  | BSS138
1 | 16MHZ | CSTNE | Y1 | Ceramic Resonator 3-Pin CSMD T/R | Murata | CSTNE8M00G550000R0
1 | LSM6DSMTR | PQFN50P300X250X86-14N | U2 | iNEMO inertial module: 3D accelerometer and 3D gyroscope | STMicroelectronics | LSM6DSMTR
1 | MP2155 | QFN10 | U4 | High Efficiency Single Inductor Buck-Boost Converter 2.2A. | MPS | MP2155GQ-Z
2 | PIN_HEADER | PIN_HEADER_2P_1.27MM | G1, G2 |  |  | DUMMY
1 | PIN_HEADER_3 | PIN_HEADER_3P | G3 |  |  | DUMMY
1 | TOUCH_GLASS | TOUCH_GLASS | G4 |  |  | DUMMY
1 | TPS61032RSAR | 16-VQFN | U5 | Boost Switching Regulator IC Positive Fixed 5V | Texas Instruments | TPS61032RSAR
1 | TPS61087DRC | 10-VSON | U6 | Boost Switching Regulator IC Positive Adjustable | Texas Instruments | TPS61087DRC
5 | Apple USB C type |  |  |  |  |  |  | OK
5 | Apple USB |  |  |  |  |  |  | OK
1 | 525590652 | 525590652 | X2 | FFC CABLE CONNECTOR | Molex | 525590652
1 | N2510-6002-RB | 10 position 0.100" (2.54mm) | X1 | 3M Header | 3M | N2510-6002-RB

Sheet: CABLES
Qty | Description | Remark
1 | FPC cable 0.5mm pitch 10 pin, 0.30mm thick, 50mm lenght, 3mm conductor. | Chinese Brand, Please check the attached picture. If this not what you want, please give me more details.
1 | FFC cable 0.5mm pitch 06 pin, 0.30mm thick, 150mm lenght, 3mm conductor. | Chinese Brand, please check and confirm the attached picture | FPC
1 | USBASP 2.0V AVR Programmer with cable. | Chinese Brand, please check and confirm the attached picture | OK PINOUT PLEASE
 |  | CONFIRM PINOUT PLEASE
