eSpark-Backup/brianperi-smartwatch/Deliverables/Bracelet(Main)/Supporting Files/Bracelet_Main.step

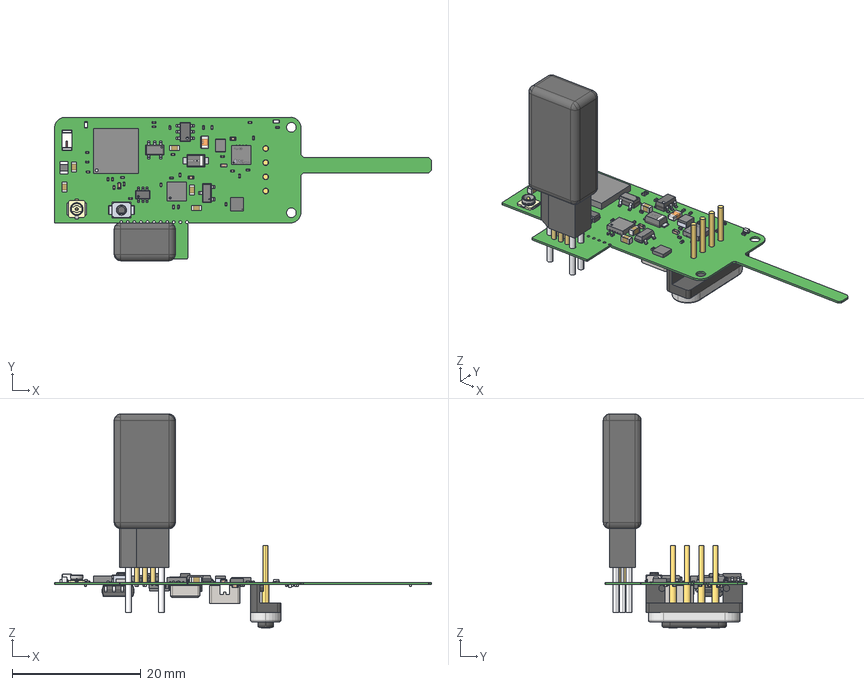
[picture p60: CAD file, 2021-07-15]
Deliverables/Bracelet(Main)/Supporting Files/Bracelet_Main.step
58.5 x 22.3 x 33.2 mm
Board
UDFN8_2X2_MCH
SOT23_NXP
Imported x 2
Inlay
User_Library-S-PWQFN-N16
pogo_connector_female_4-pin
User_Library-SOD123W
amdla4530q-4r7mt
User_Library-SMD_Ceramic_Capacitors_0201_(0603)_AB x 32
User_Library-Capacitor_0402 x 10
User_Library-SOT23-6-2
ms0420-100m
U.FL-R-SMT-1
User_Library-CAPC1608X09 x 5
SOP-8
CircuitWorks-SOT-23
ESP32-PICO-D4--3DModel-STEP-56544
User_Library-0201(0603M)_Res x 19
User_Library-OMRON_B3U1000P
LDF
CPD
SN74LV1T34DBVR
DFN_10011
ICM-20948--3DModel-STEP-56544
User_Library-SOT363-2
APHHS1005 x 2
DFE201610E-1R0M=P2
User_Library-0805_SMD_Capacitor
User_Library-TC2030
