eSpark-Backup/brianperi-smartwatch/Deliverables/Bracelet(Aux_v2.0)/Supporting Files/Bracelet_Aux_v2.0.step

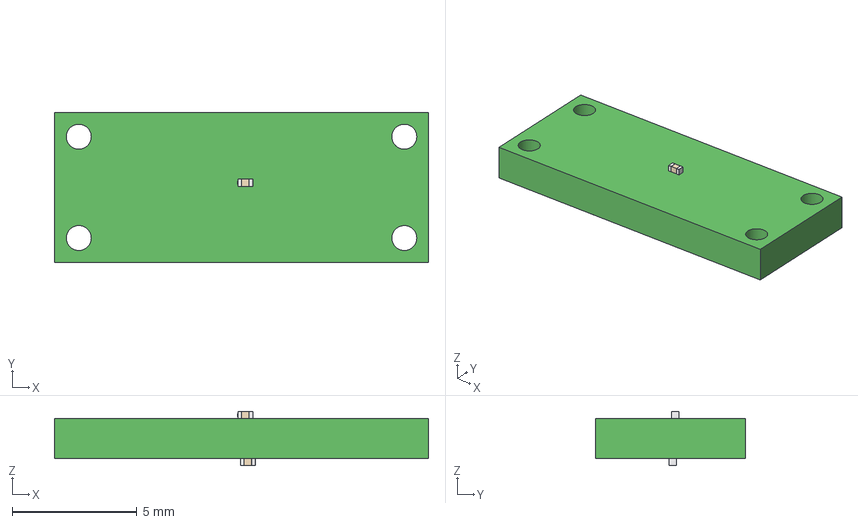
[picture p61: CAD file, 2021-07-15]
Deliverables/Bracelet(Aux_v2.0)/Supporting Files/Bracelet_Aux_v2.0.step
15.0 x 6.01 x 2.17 mm
Board
User_Library-SMD_Ceramic_Capacitors_0201_(0603)_AB x 2
