eSpark-Backup/brianperi-smartwatch/Deliverables/Bracelet(Aux_v1.0)/Supporting Files/Bracelet_Aux_v1.0.step

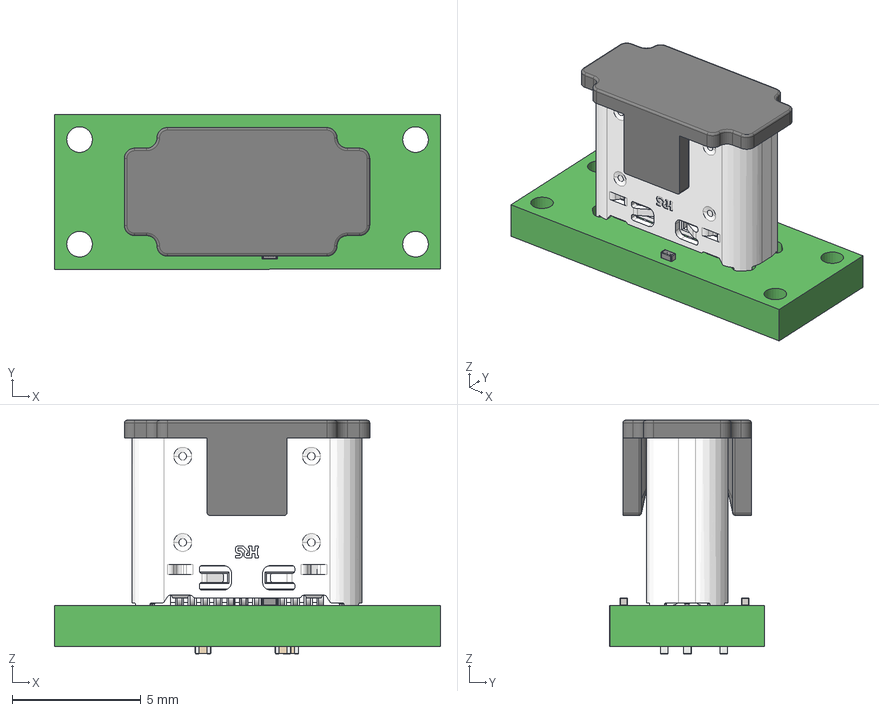
[picture p62: CAD file, 2021-07-15, an earlier design]
Deliverables/Bracelet(Aux_v1.0)/Supporting Files/Bracelet_Aux_v1.0.step
15.0 x 6.00 x 9.08 mm
Board
02_CX80B1-24P_CAP
01_CX80B1-24P_ASSY
User_Library-0201(0603M)_Res x 2
User_Library-SMD_Ceramic_Capacitors_0201_(0603)_AB x 5
