eSpark-Backup/brianperi-smartwatch/(list of files, cad)

Other CAD files:
Deliverables/Bracelet(Aux_v1.0)/Supporting Files/Bracelet_Aux_v1.0.DWG
Deliverables/Bracelet(Aux_v1.0)/Supporting Files/Bracelet_Aux_v1.0.DXF
Deliverables/Bracelet(Aux_v2.0)/Supporting Files/Bracelet_Aux_v2.0.DWG
Deliverables/Bracelet(Aux_v2.0)/Supporting Files/Bracelet_Aux_v2.0.DXF
Deliverables/Bracelet(Main)/Supporting Files/Bracelet_Main.DWG
Deliverables/Bracelet(Main)/Supporting Files/Bracelet_Main.DXF
