eSpark-Backup/brianperi-smartwatch/Design-Files/Bracelet(Main)/Bracelet_Main.pdf

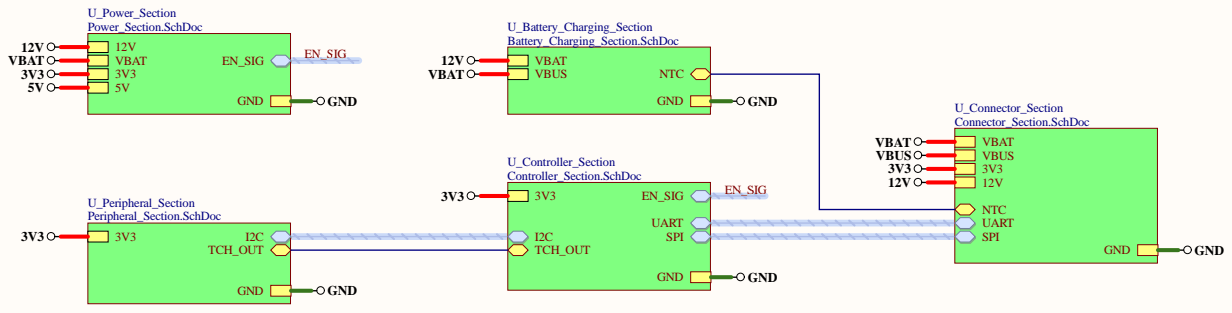
[picture p63: page 1]

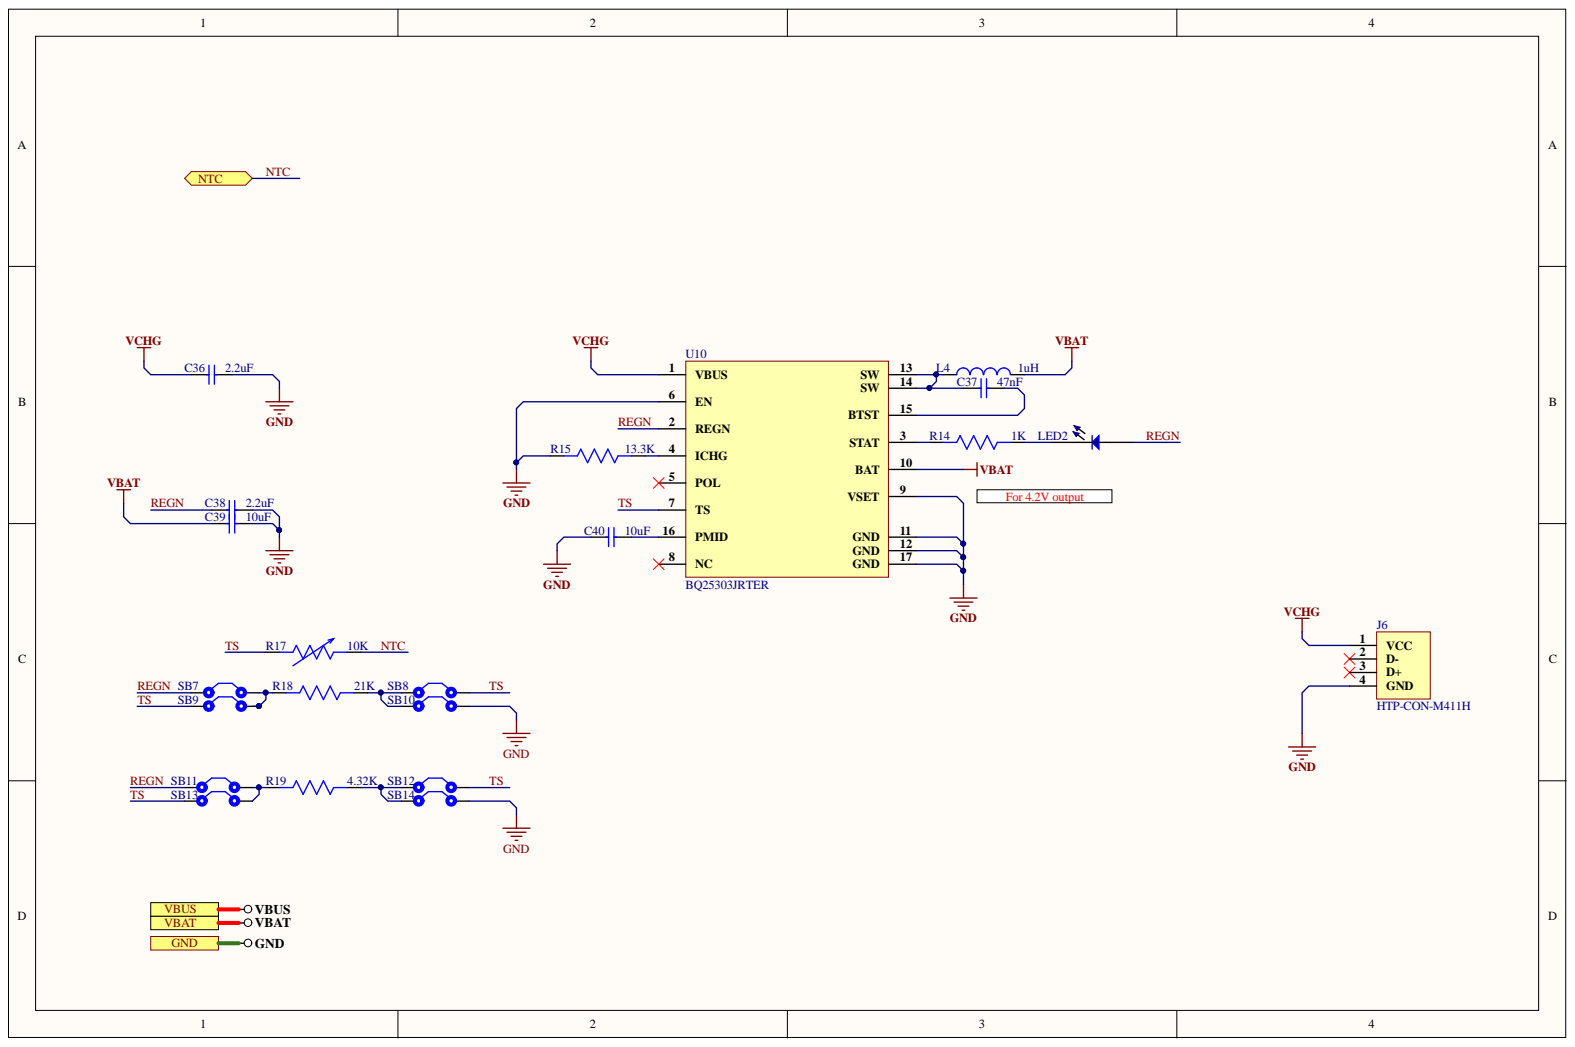
[picture p64: page 2]

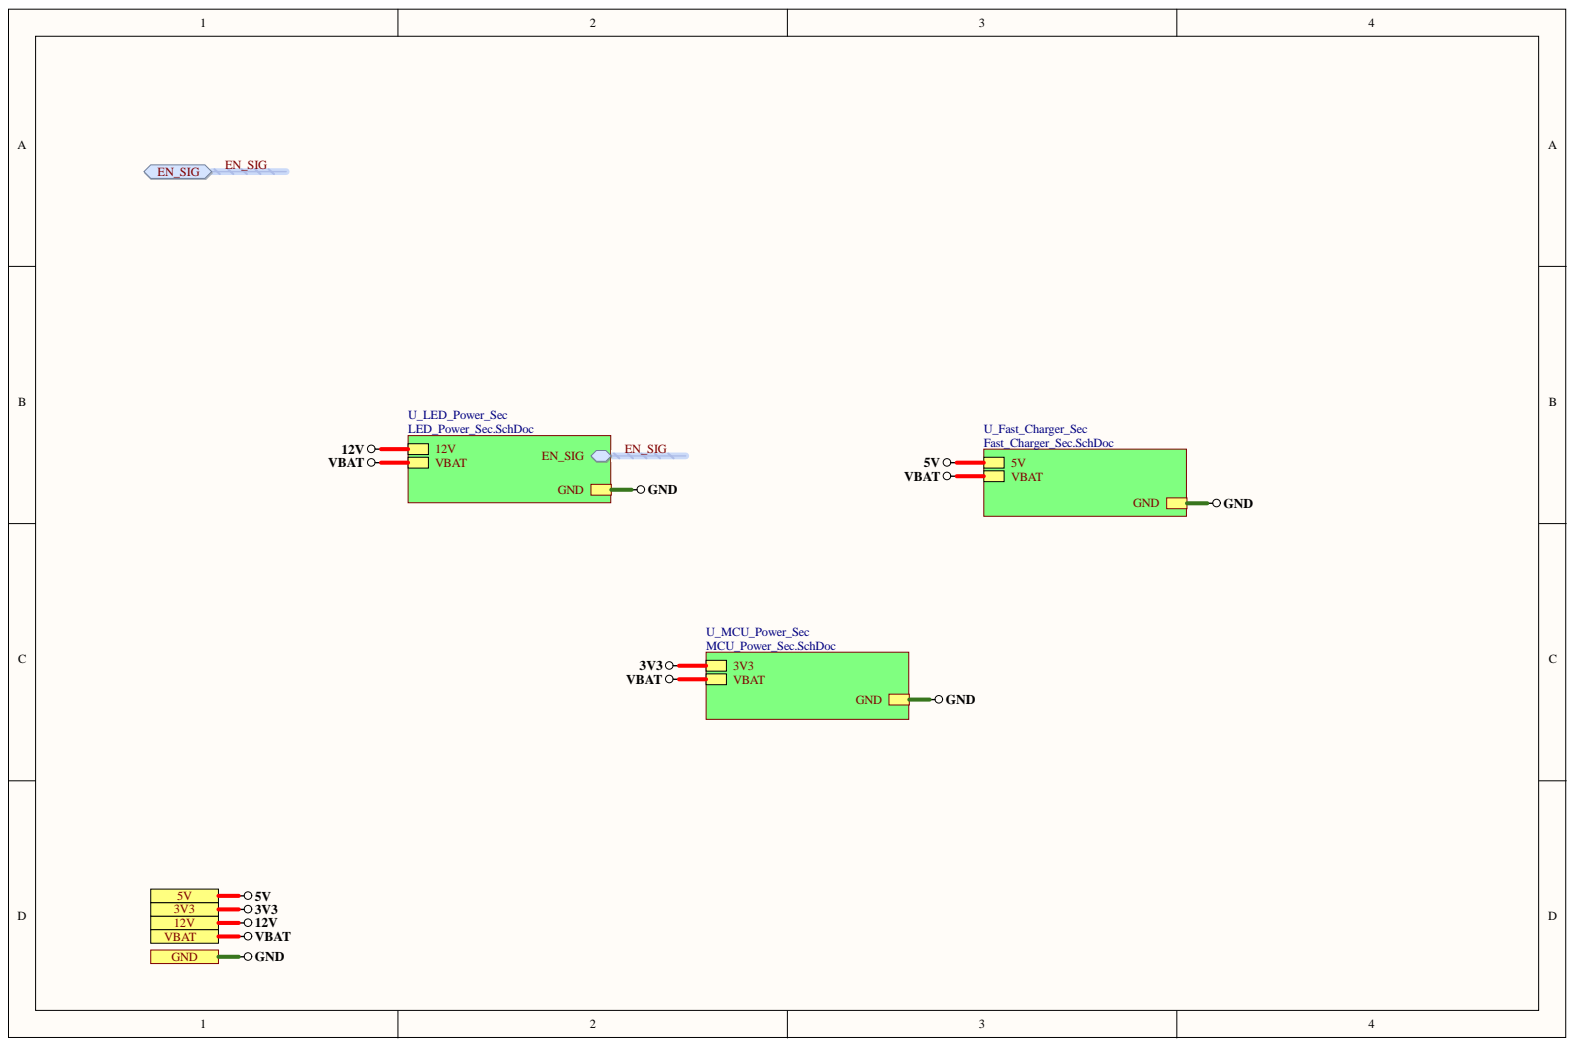
[picture p65: page 3]

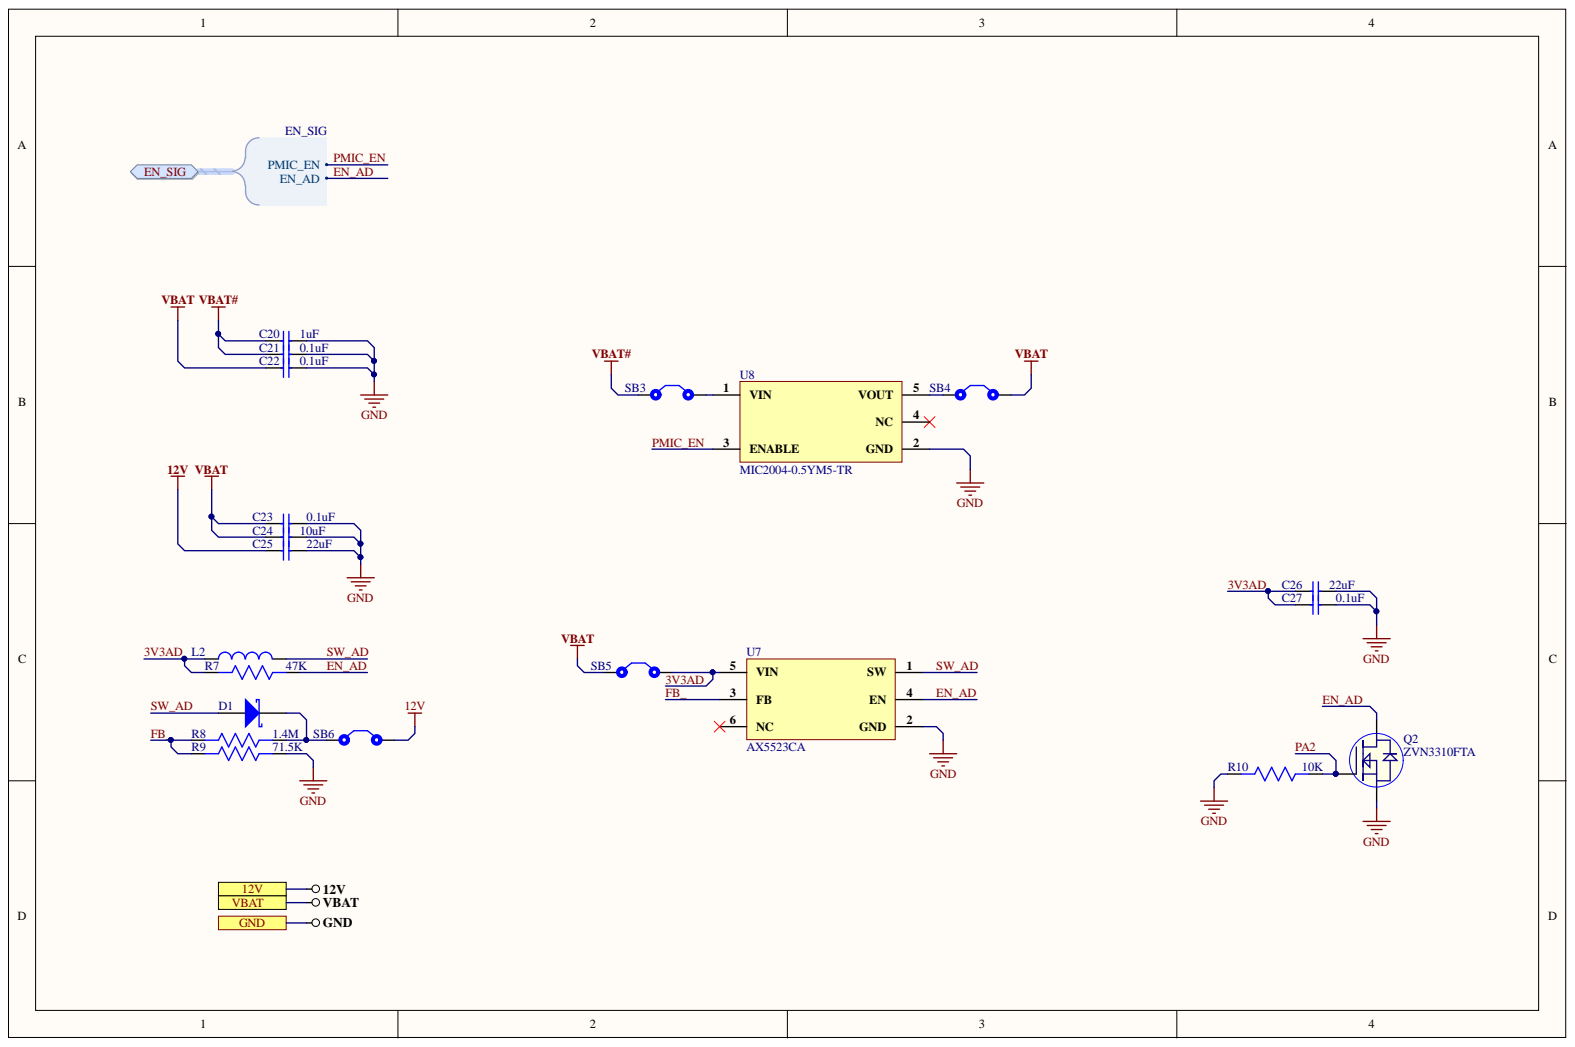
[picture p66: page 4]

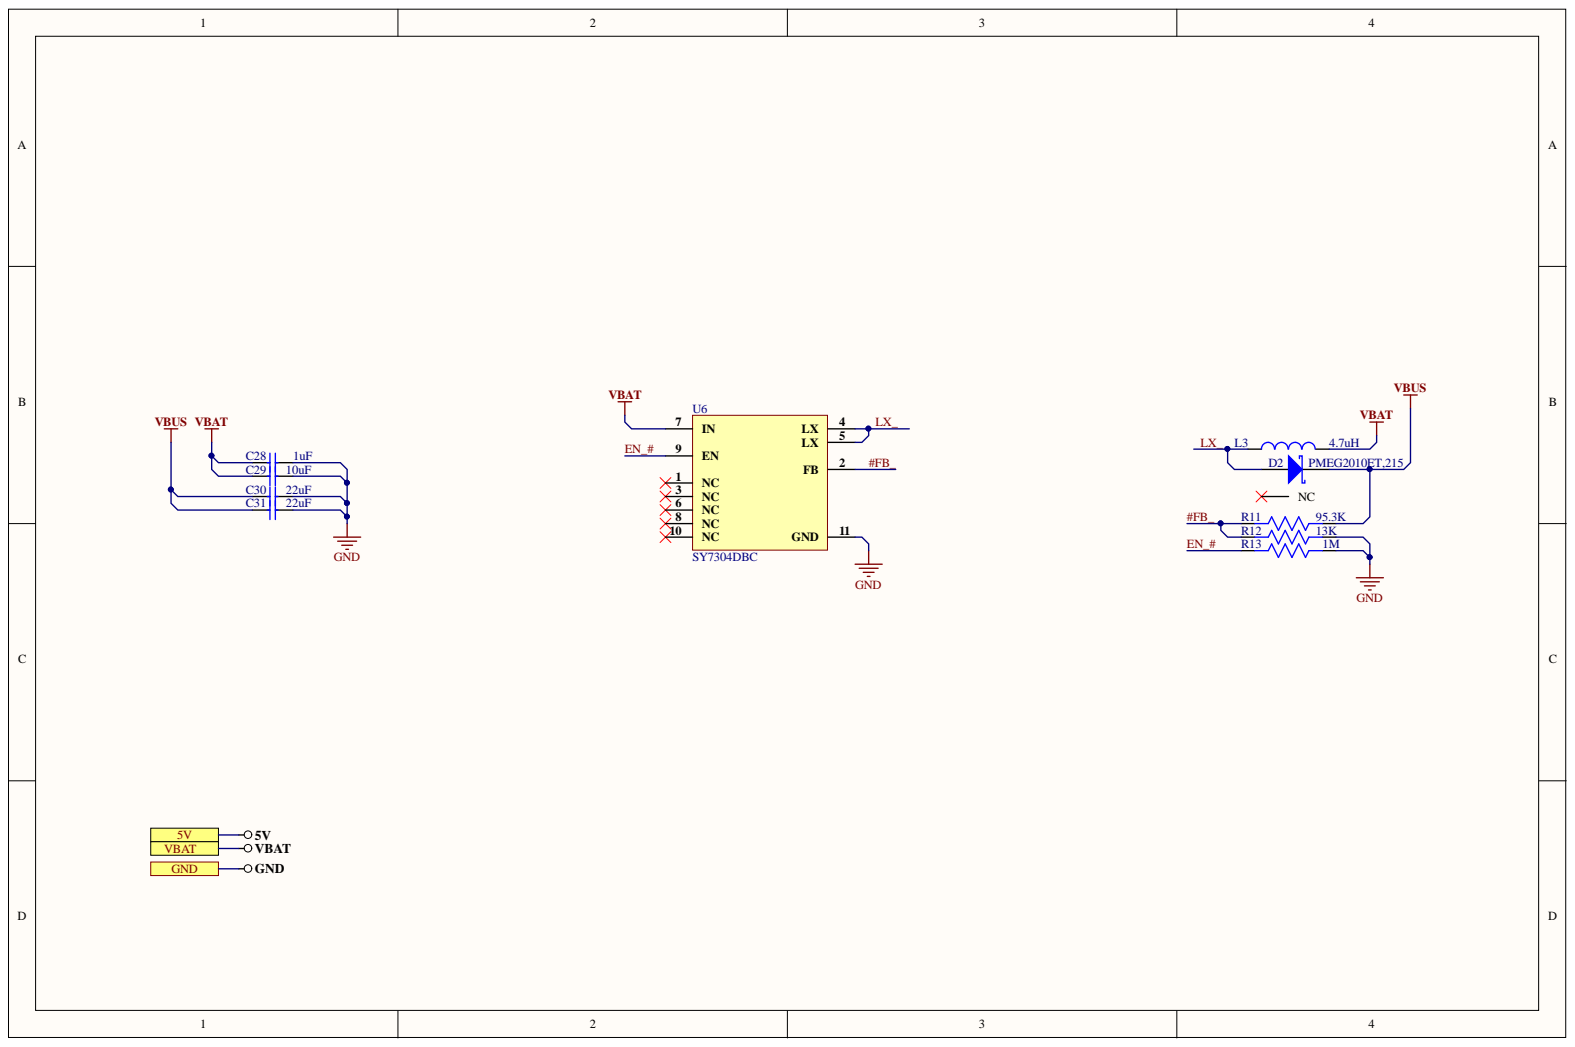
[picture p67: page 5]

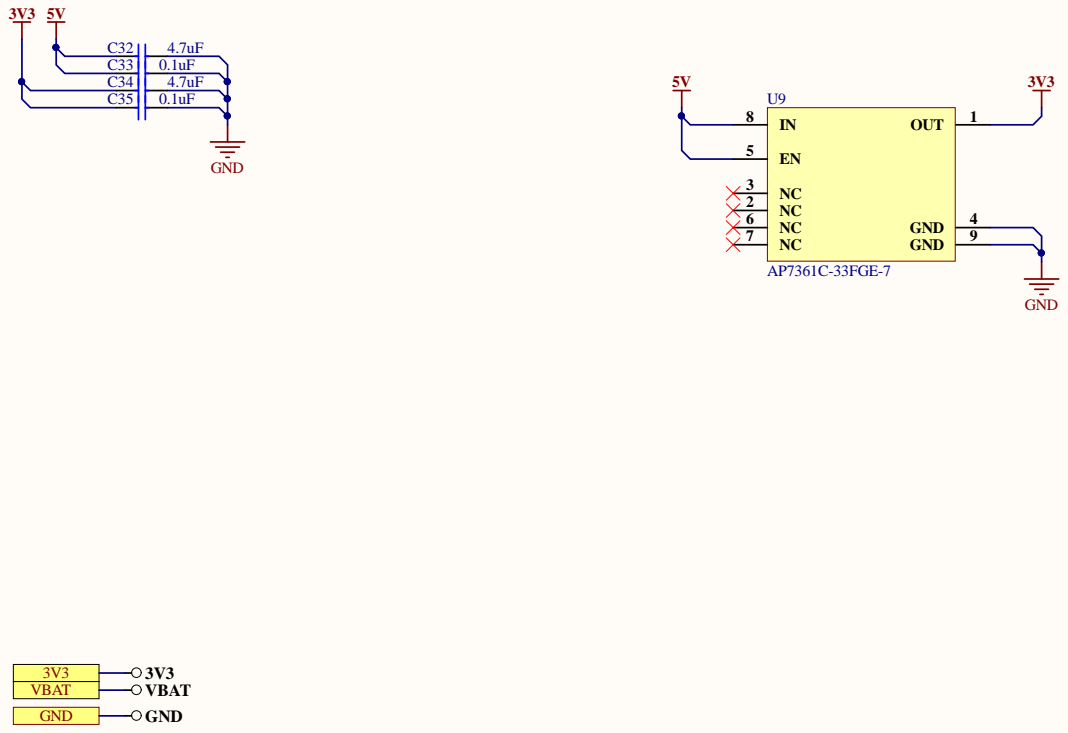
[picture p68: page 6]

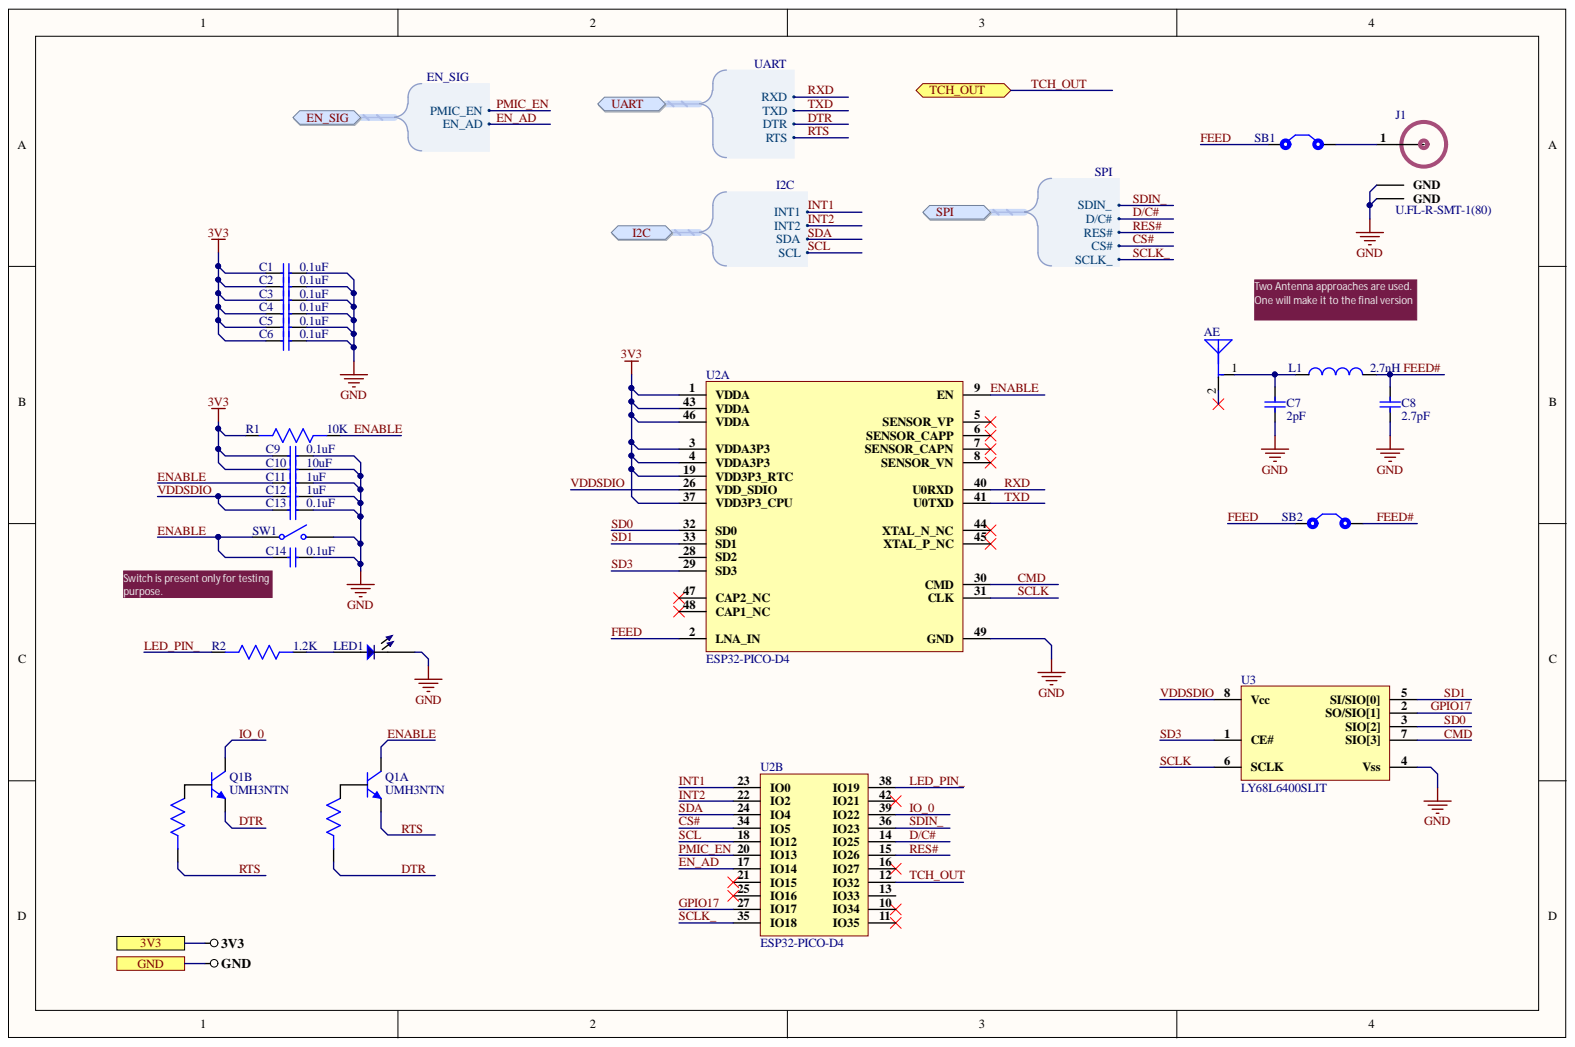
[picture p69: page 7]

Two Antenna approaches are used.
One wi

t to the final version

tch is present onl

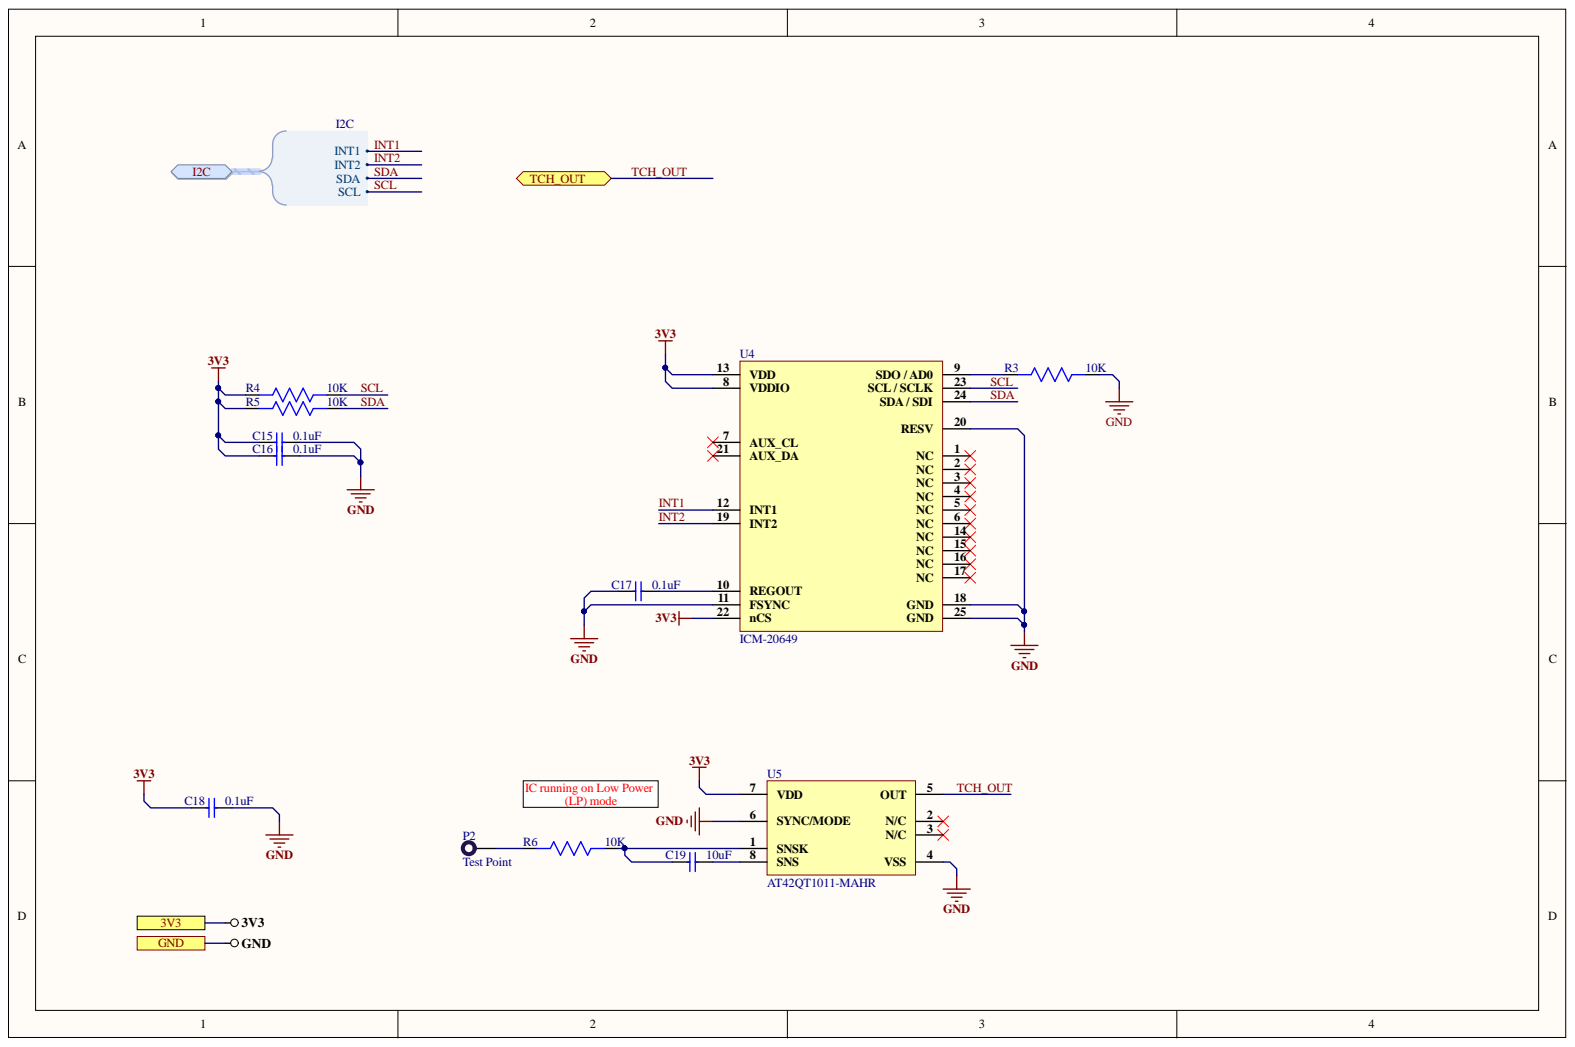
[picture p70: page 8]

IC running on Low Power

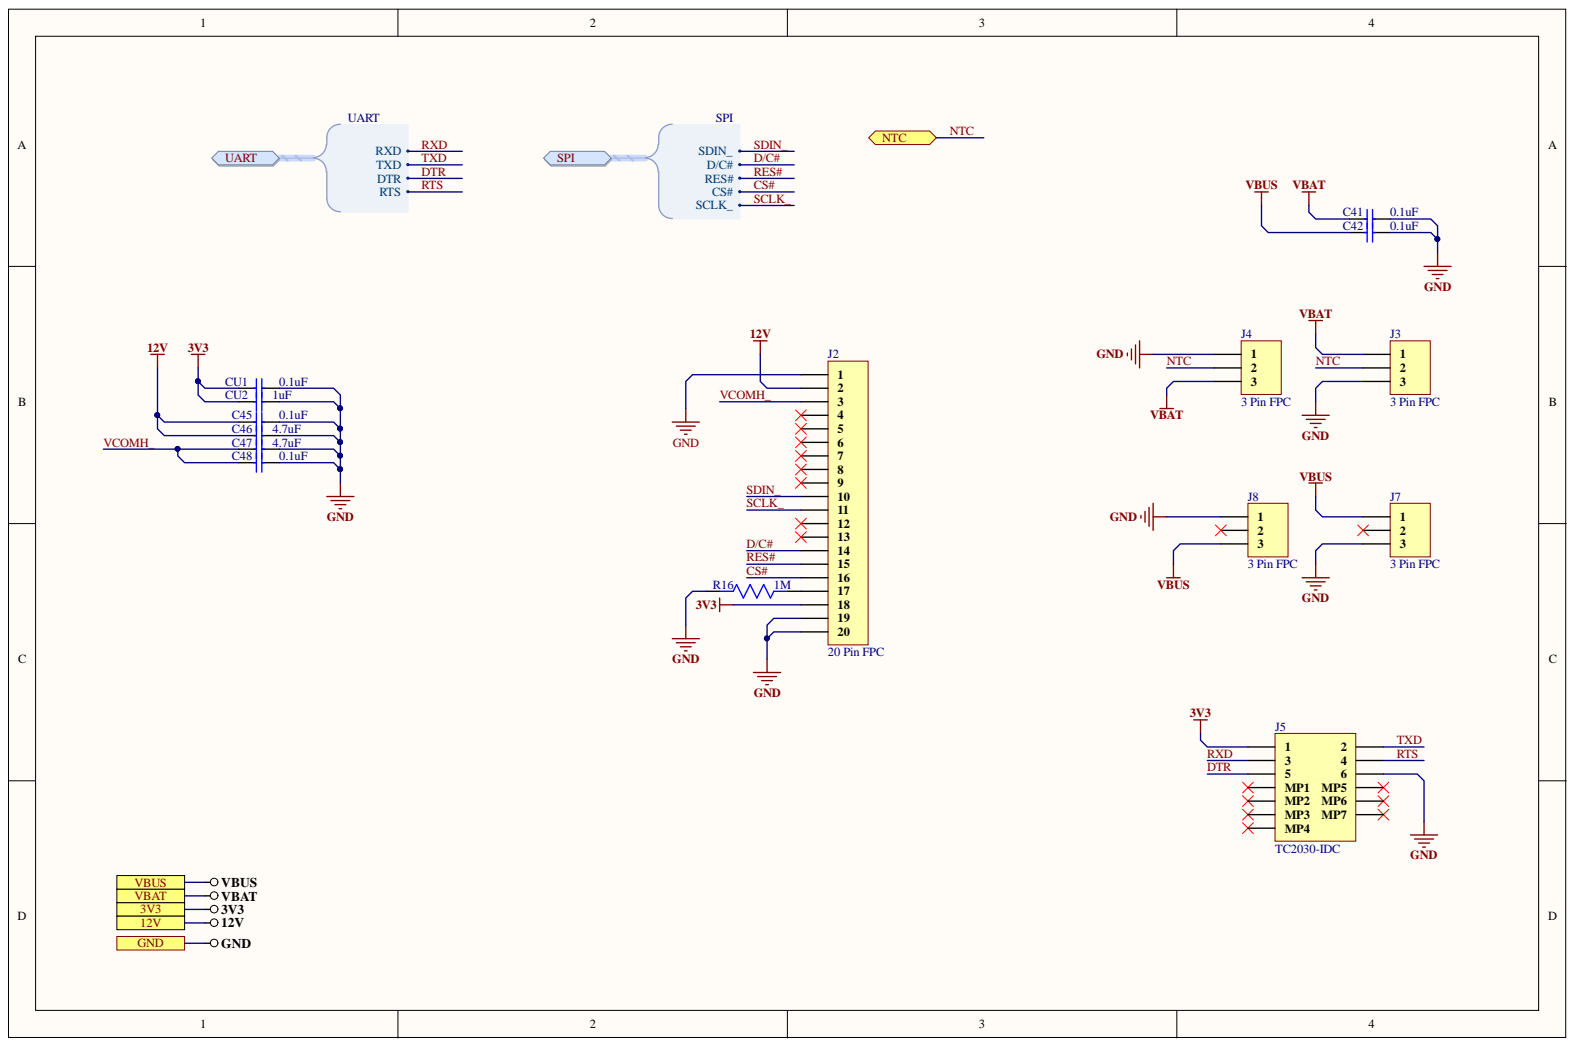
[picture p71: page 9]
