eSpark-Backup/brianperi-smartwatch/Deliverables/Bracelet(Aux_v2.0)/Schematics/Assembly_Drawing.pdf

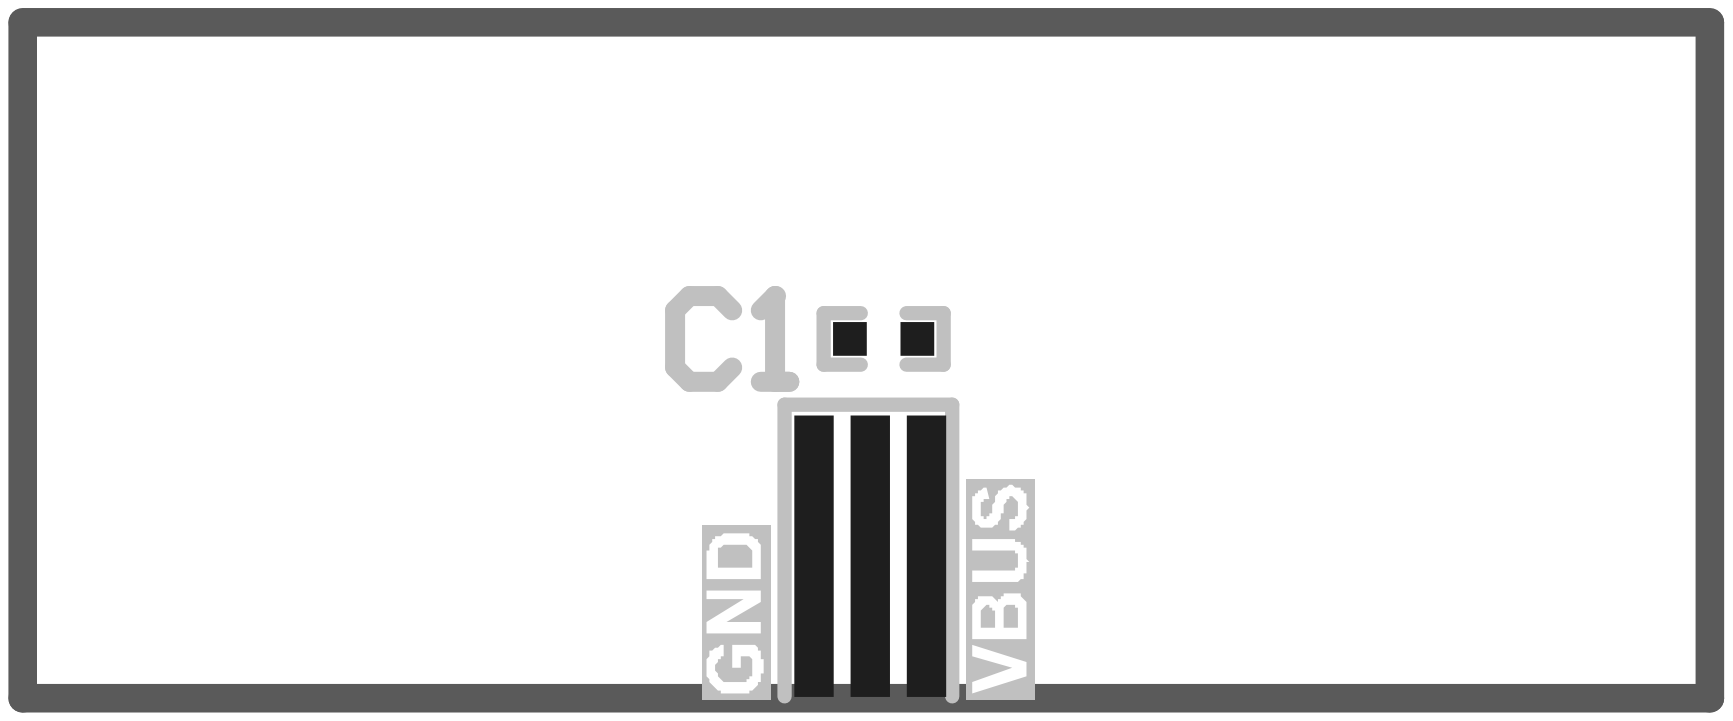
[picture p72: page 1]

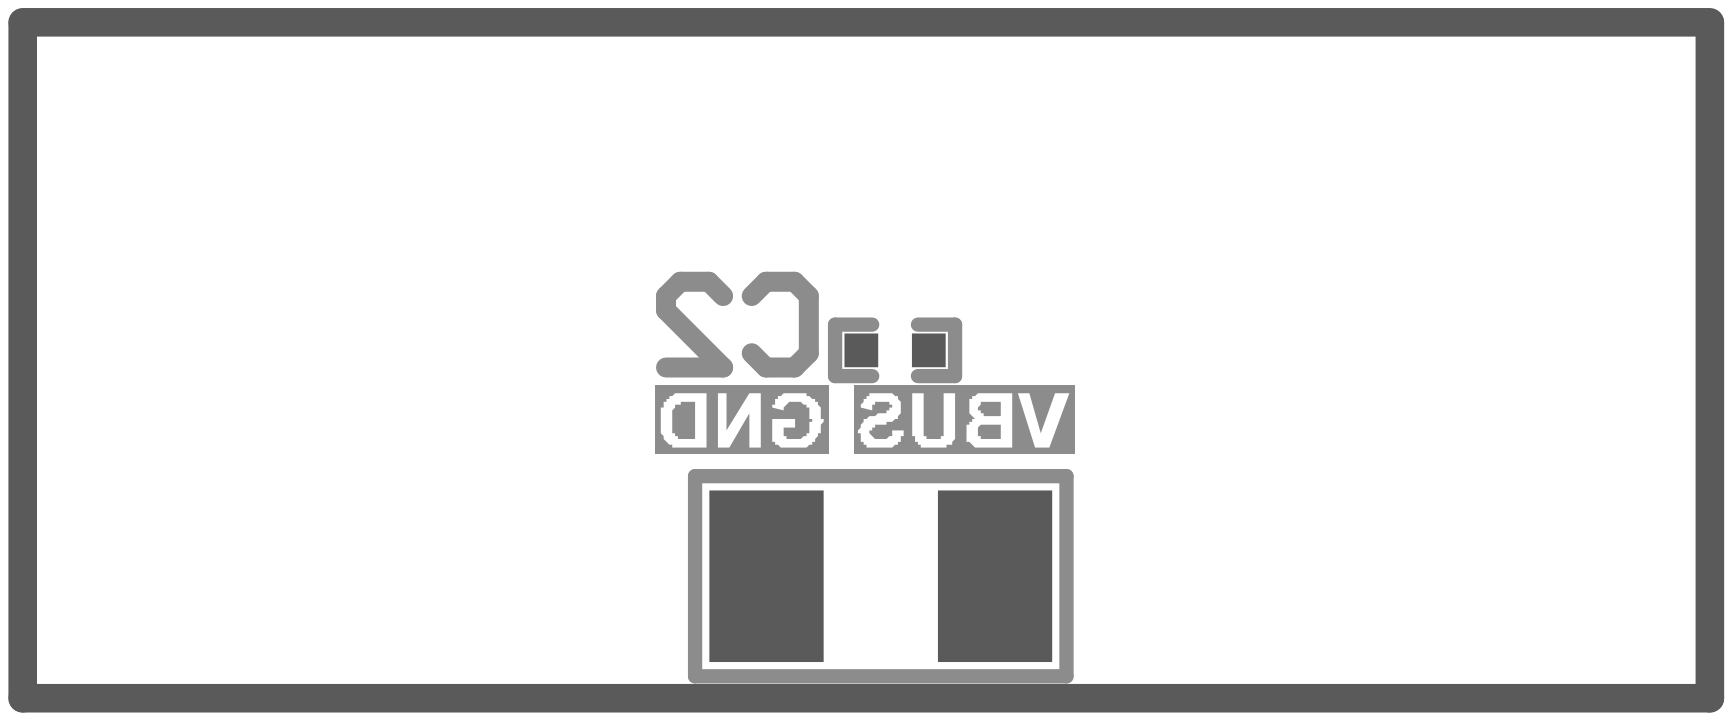
[picture p73: page 2]
