eSpark-Backup/brianperi-smartwatch/Deliverables/Bracelet(Aux_v2.0)/Schematics/Bracelet_Aux_v2.0.pdf

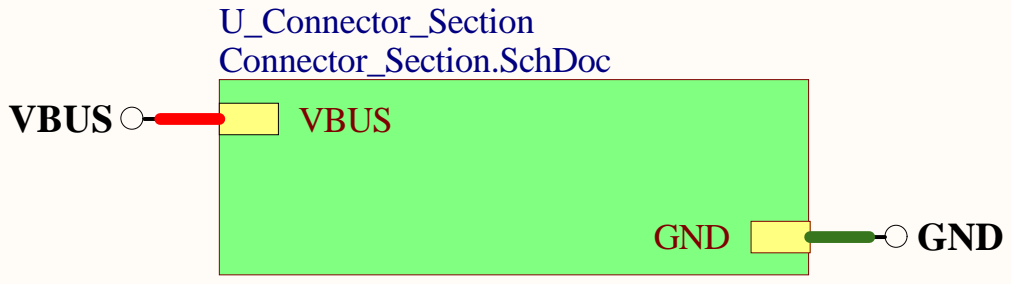
[picture p74: page 1]

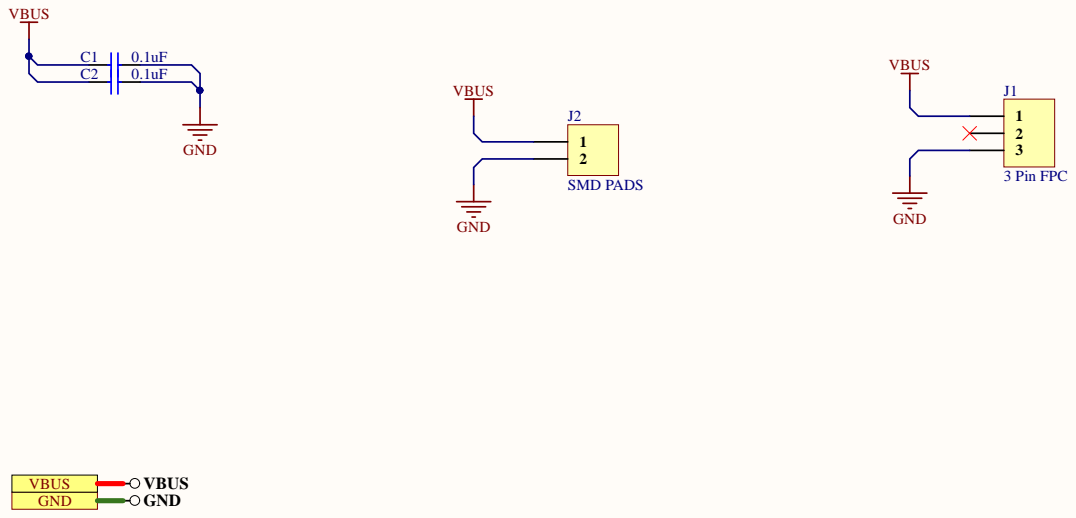
[picture p75: page 2]

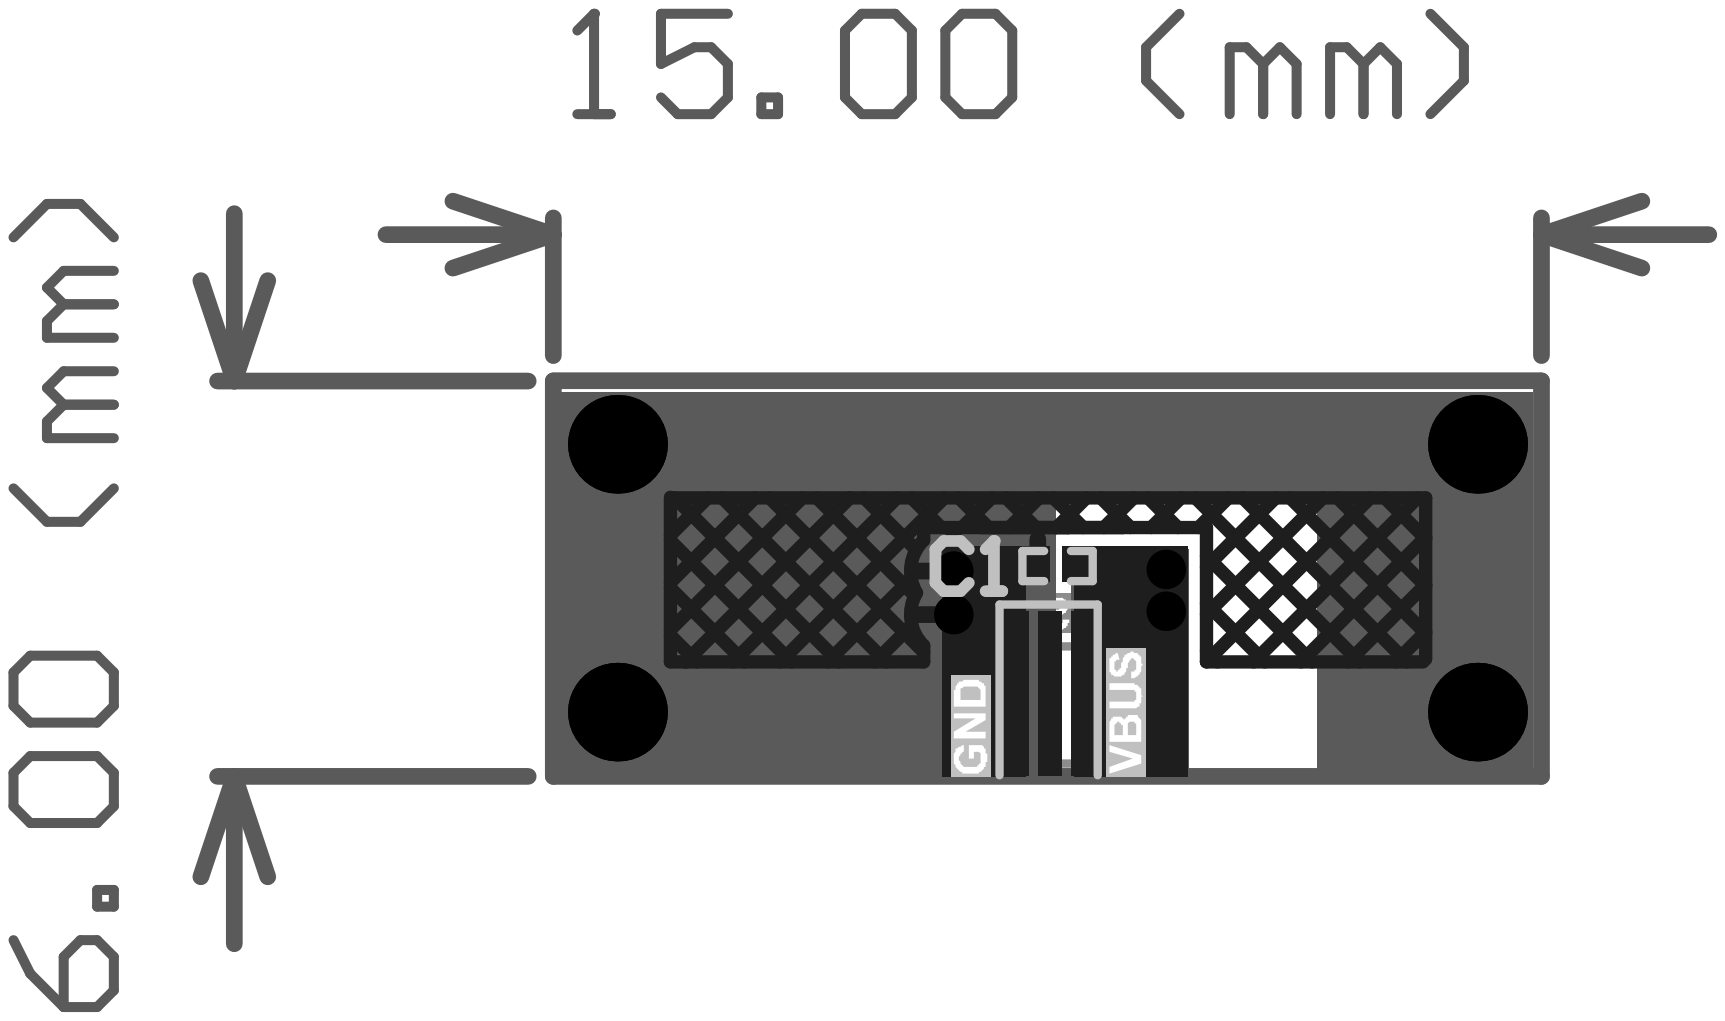
[picture p76: page 3]
