eSpark-Backup/brianperi-smartwatch/Deliverables/Bracelet(Main)/Schematics/Assembly_Drawing.pdf

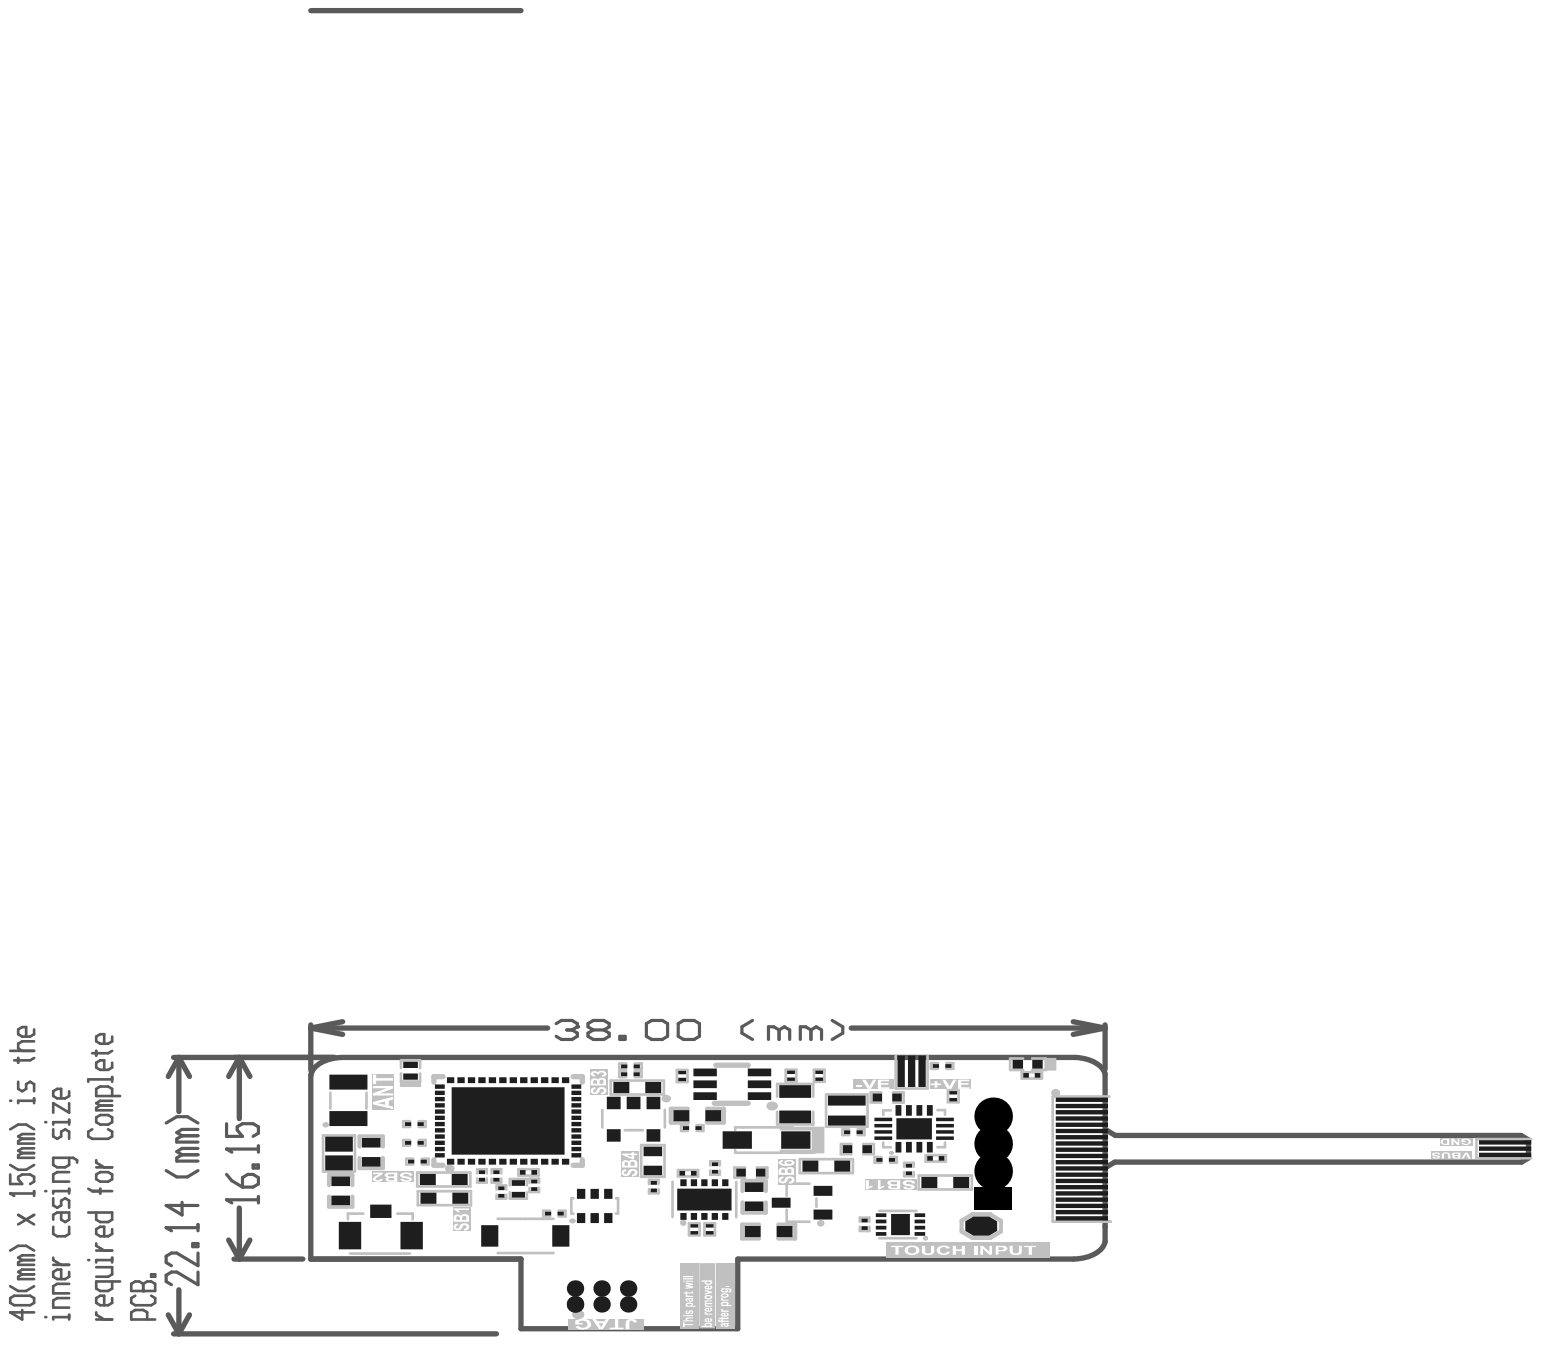
[picture p77: page 1]

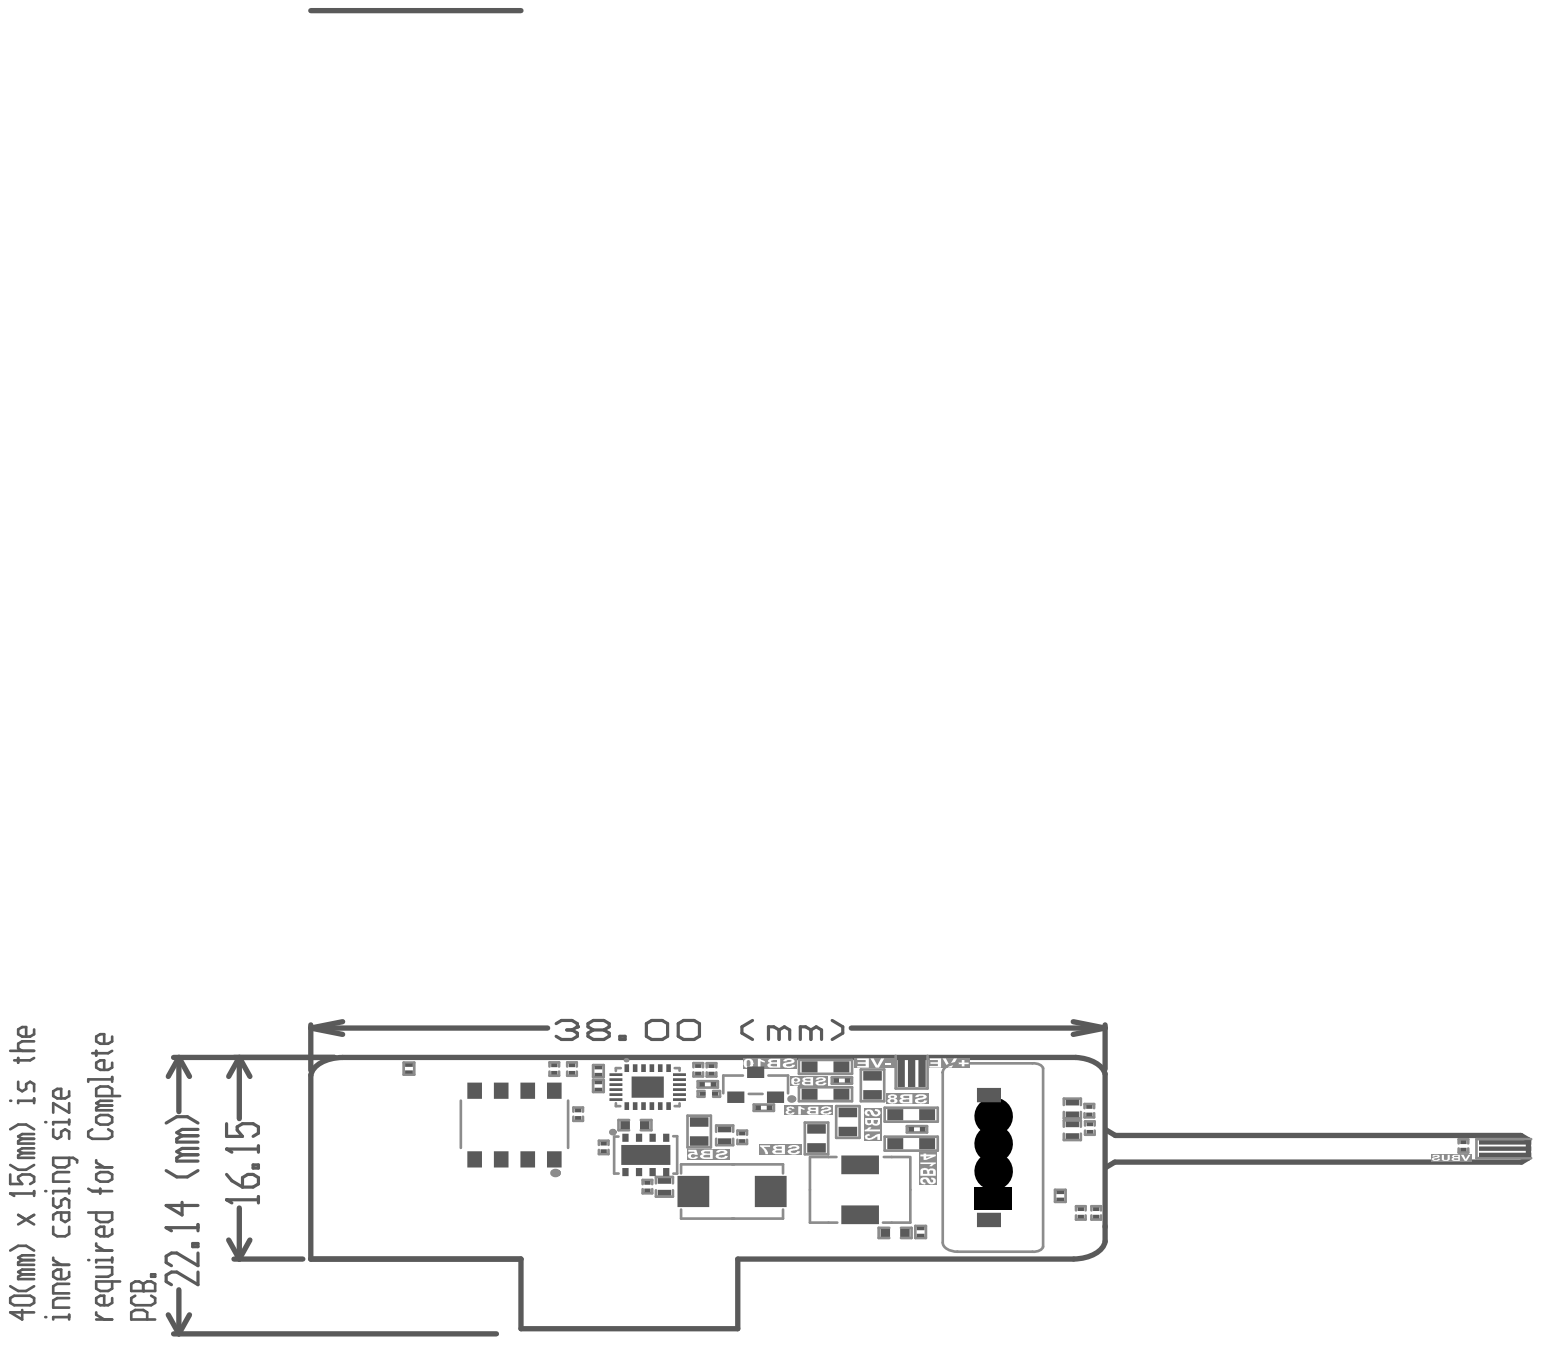
[picture p78: page 2]
