eSpark-Backup/brianperi-smartwatch/Deliverables/Bracelet(Aux_v1.0)/Schematics/Assembly_Drawing.pdf

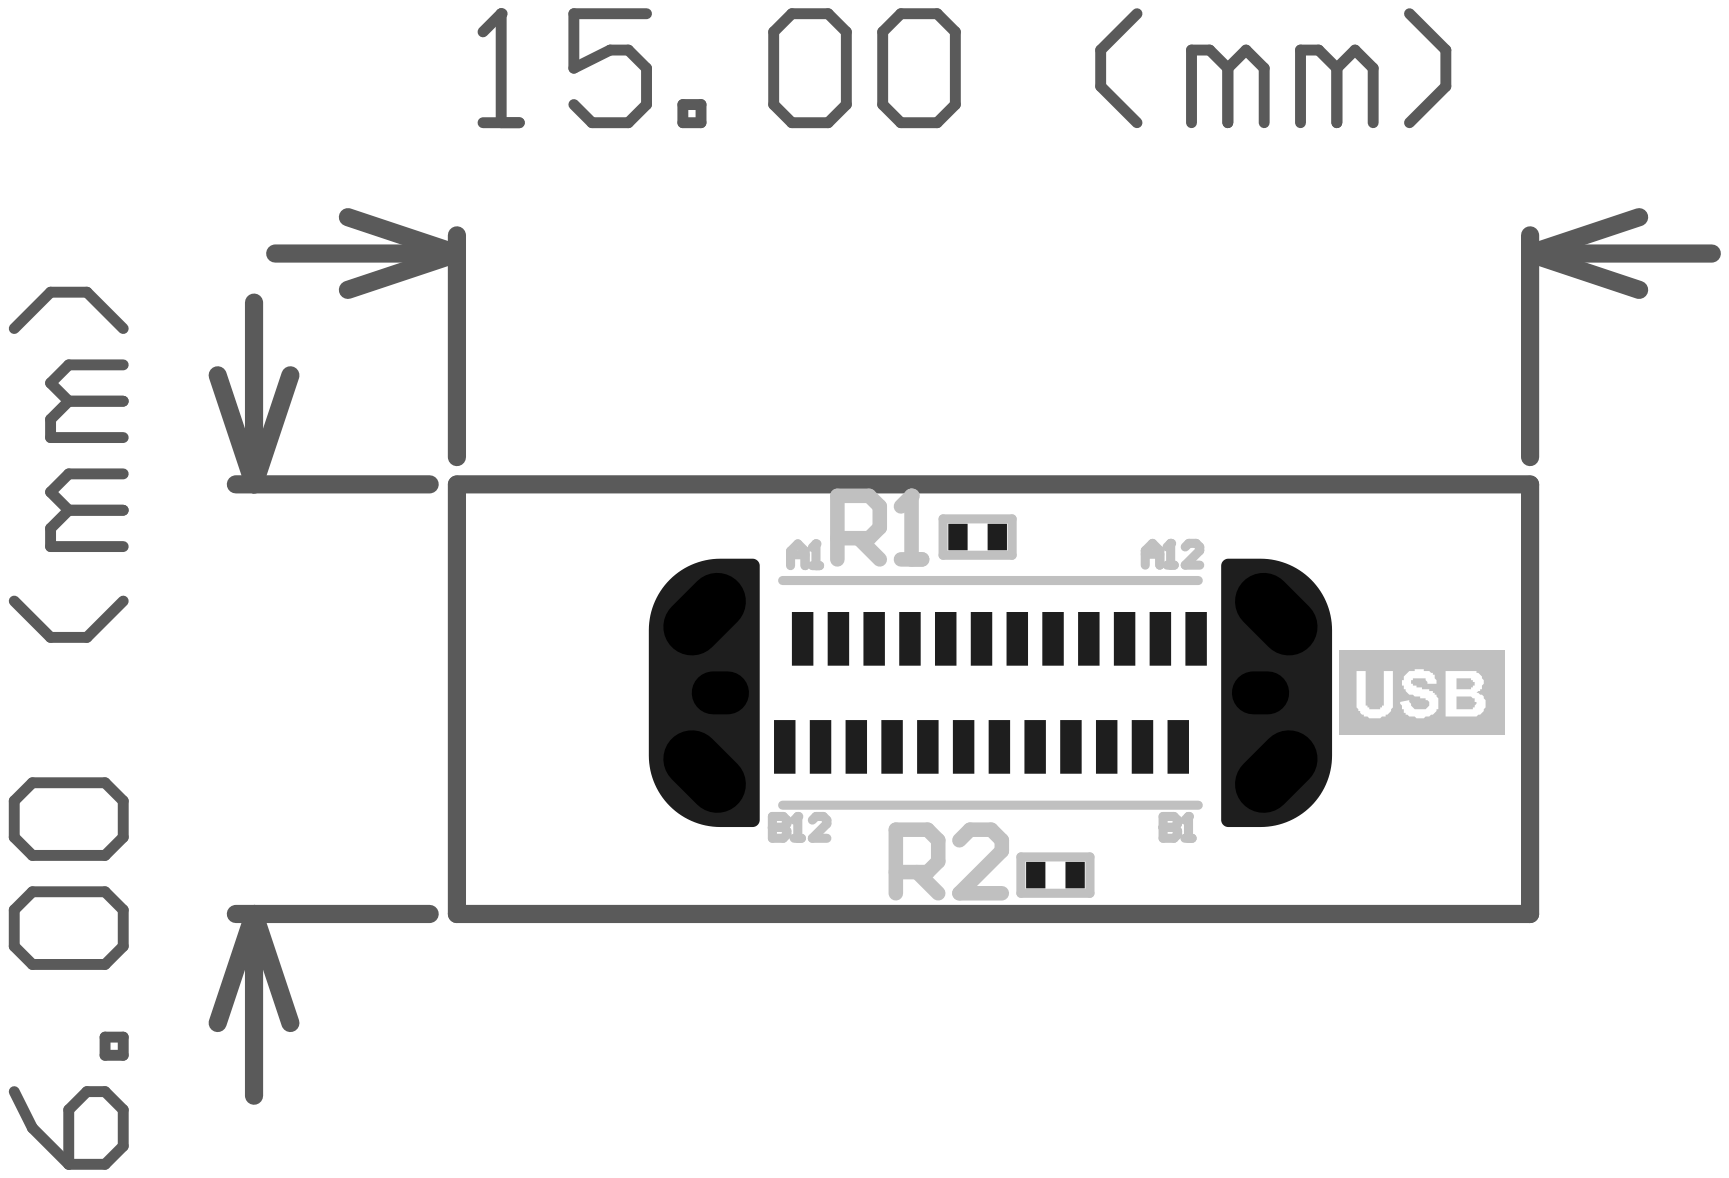
[picture p79: page 1]

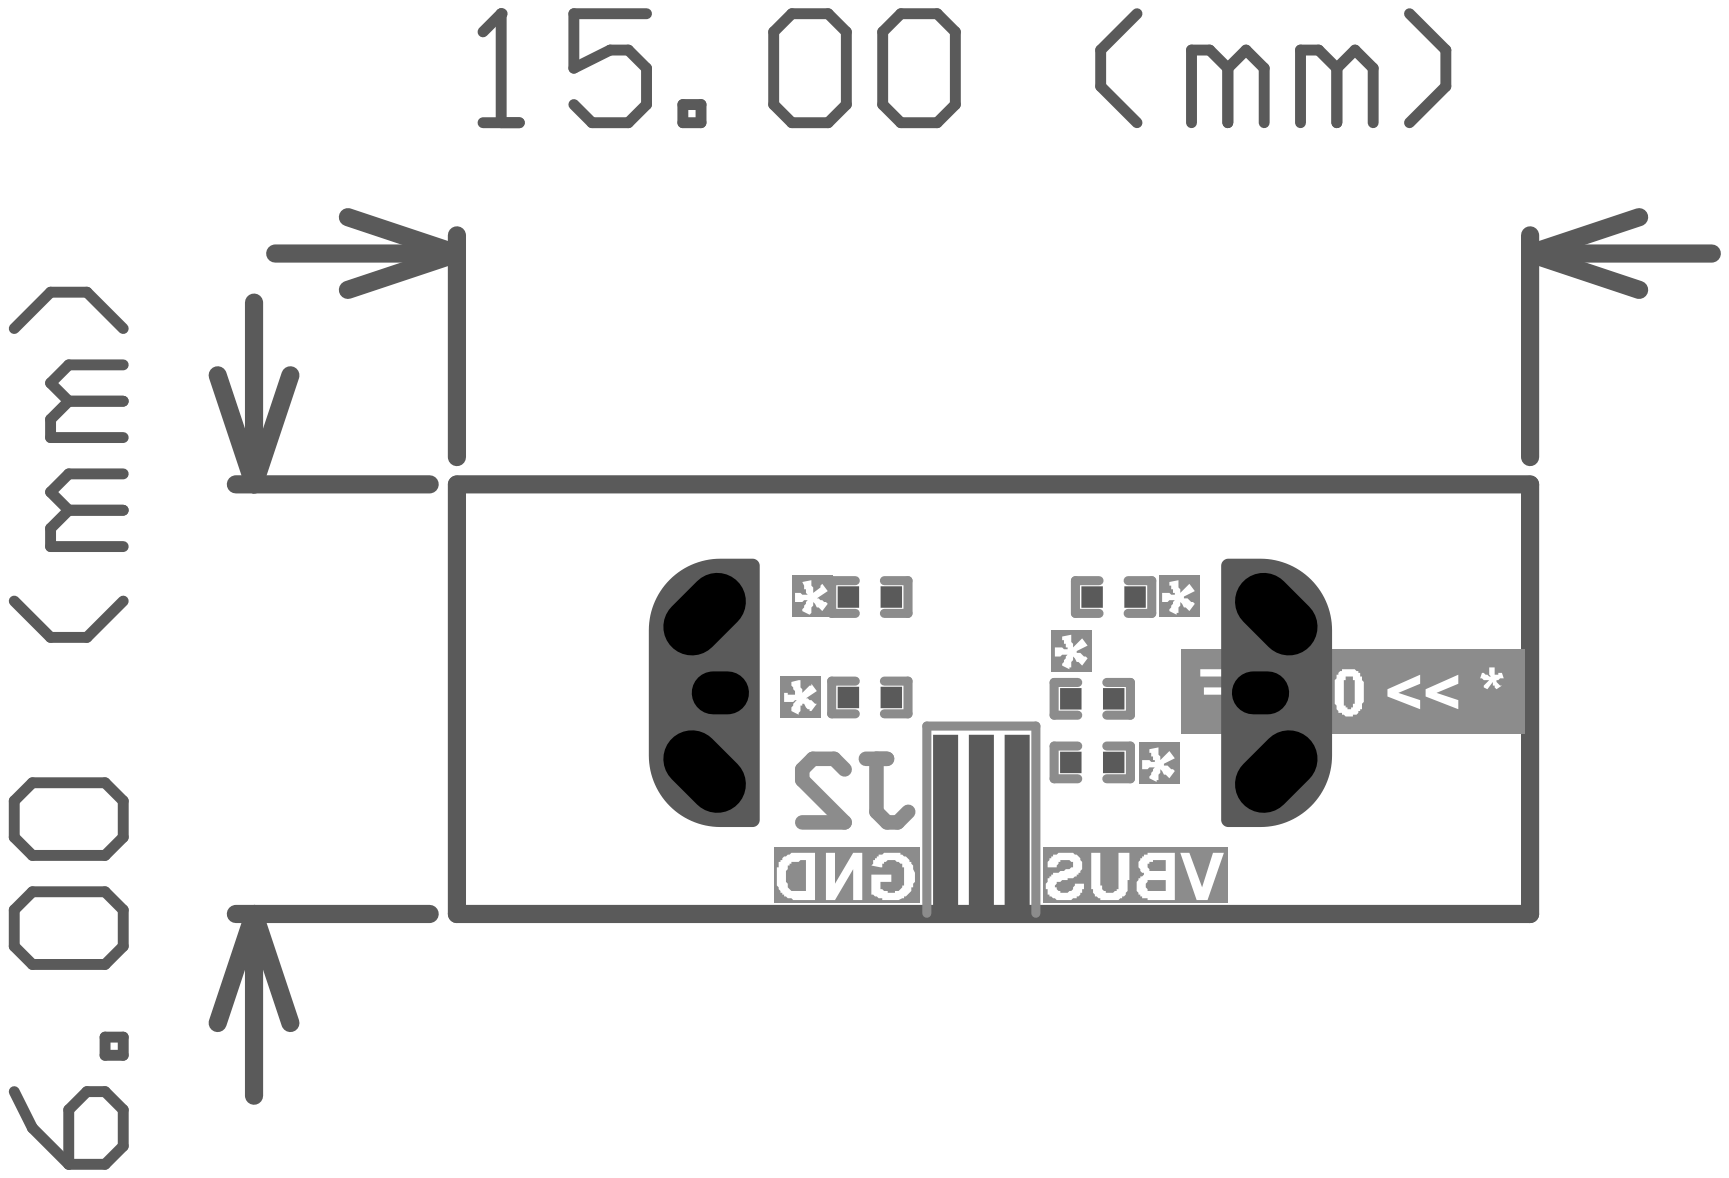
[picture p80: page 2]
