eSpark-Backup/brianperi-smartwatch/Deliverables/Bracelet(Aux_v1.0)/Schematics/Bracelet_Aux_v1.0.pdf

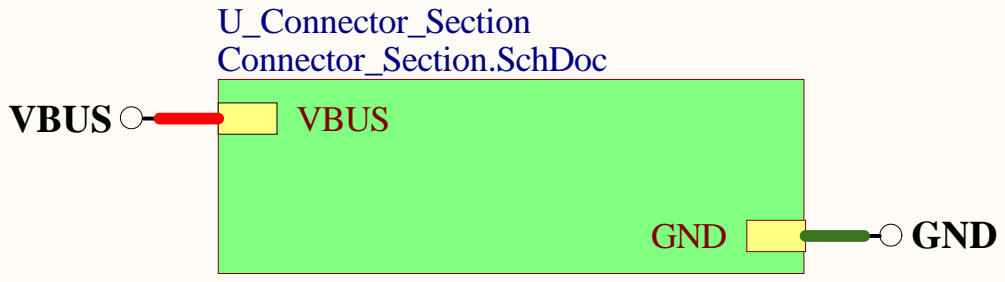
[picture p81: page 1]

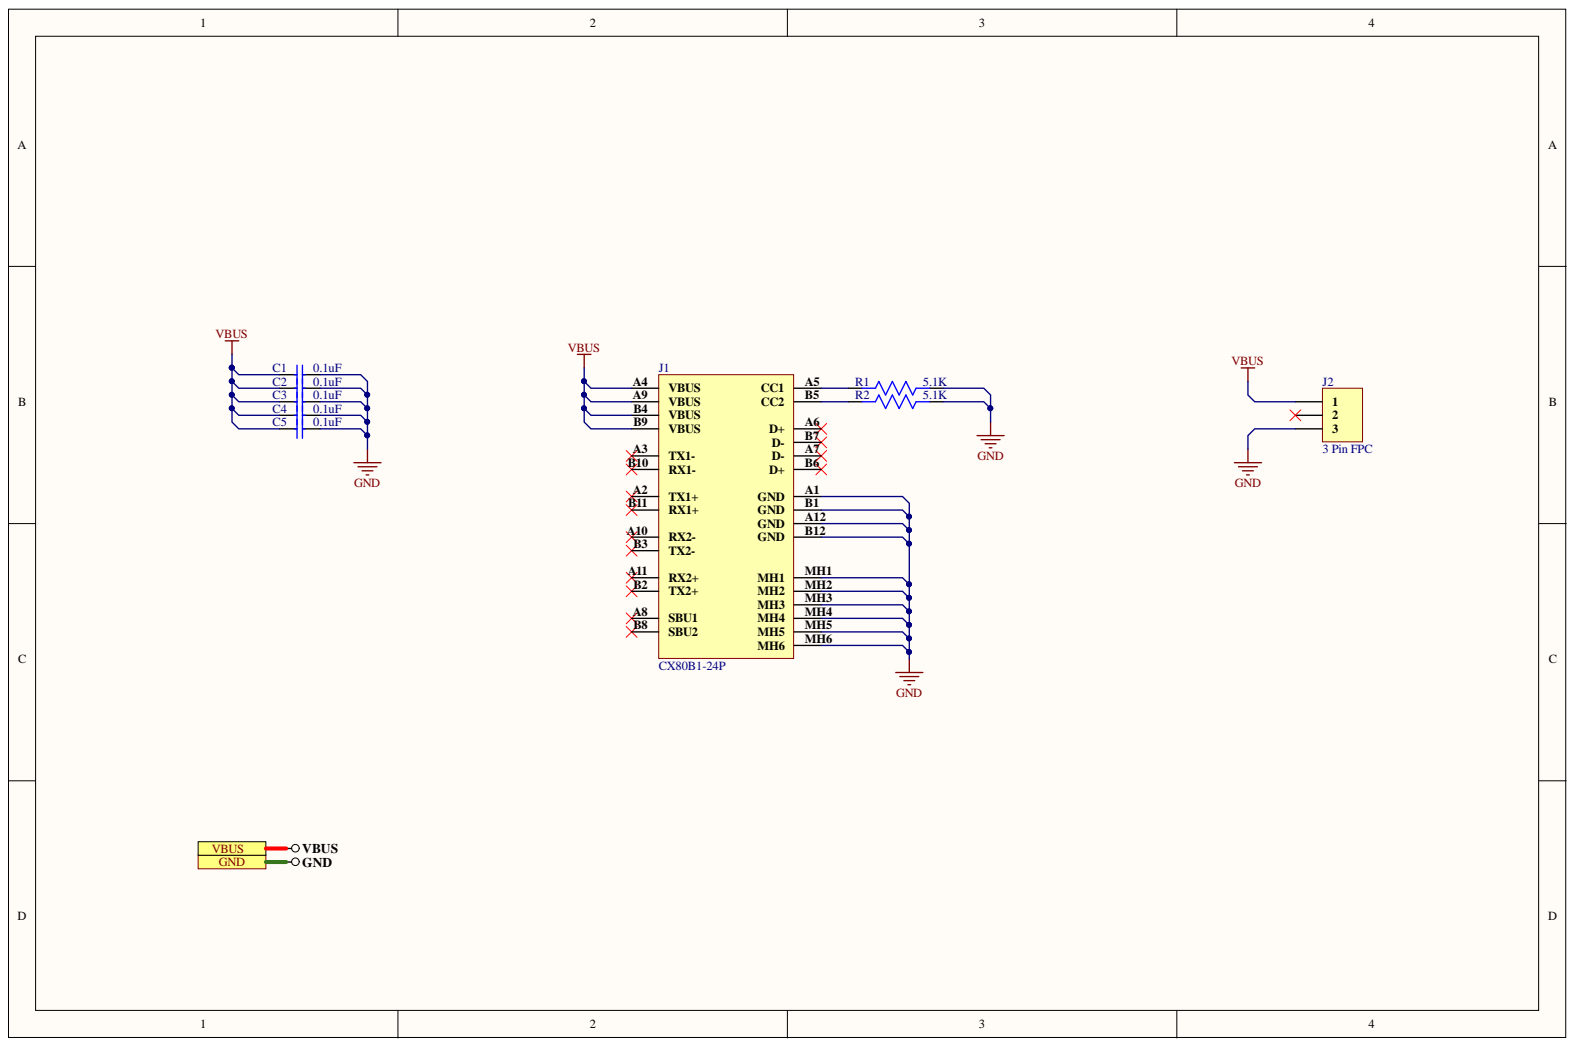
[picture p82: page 2]

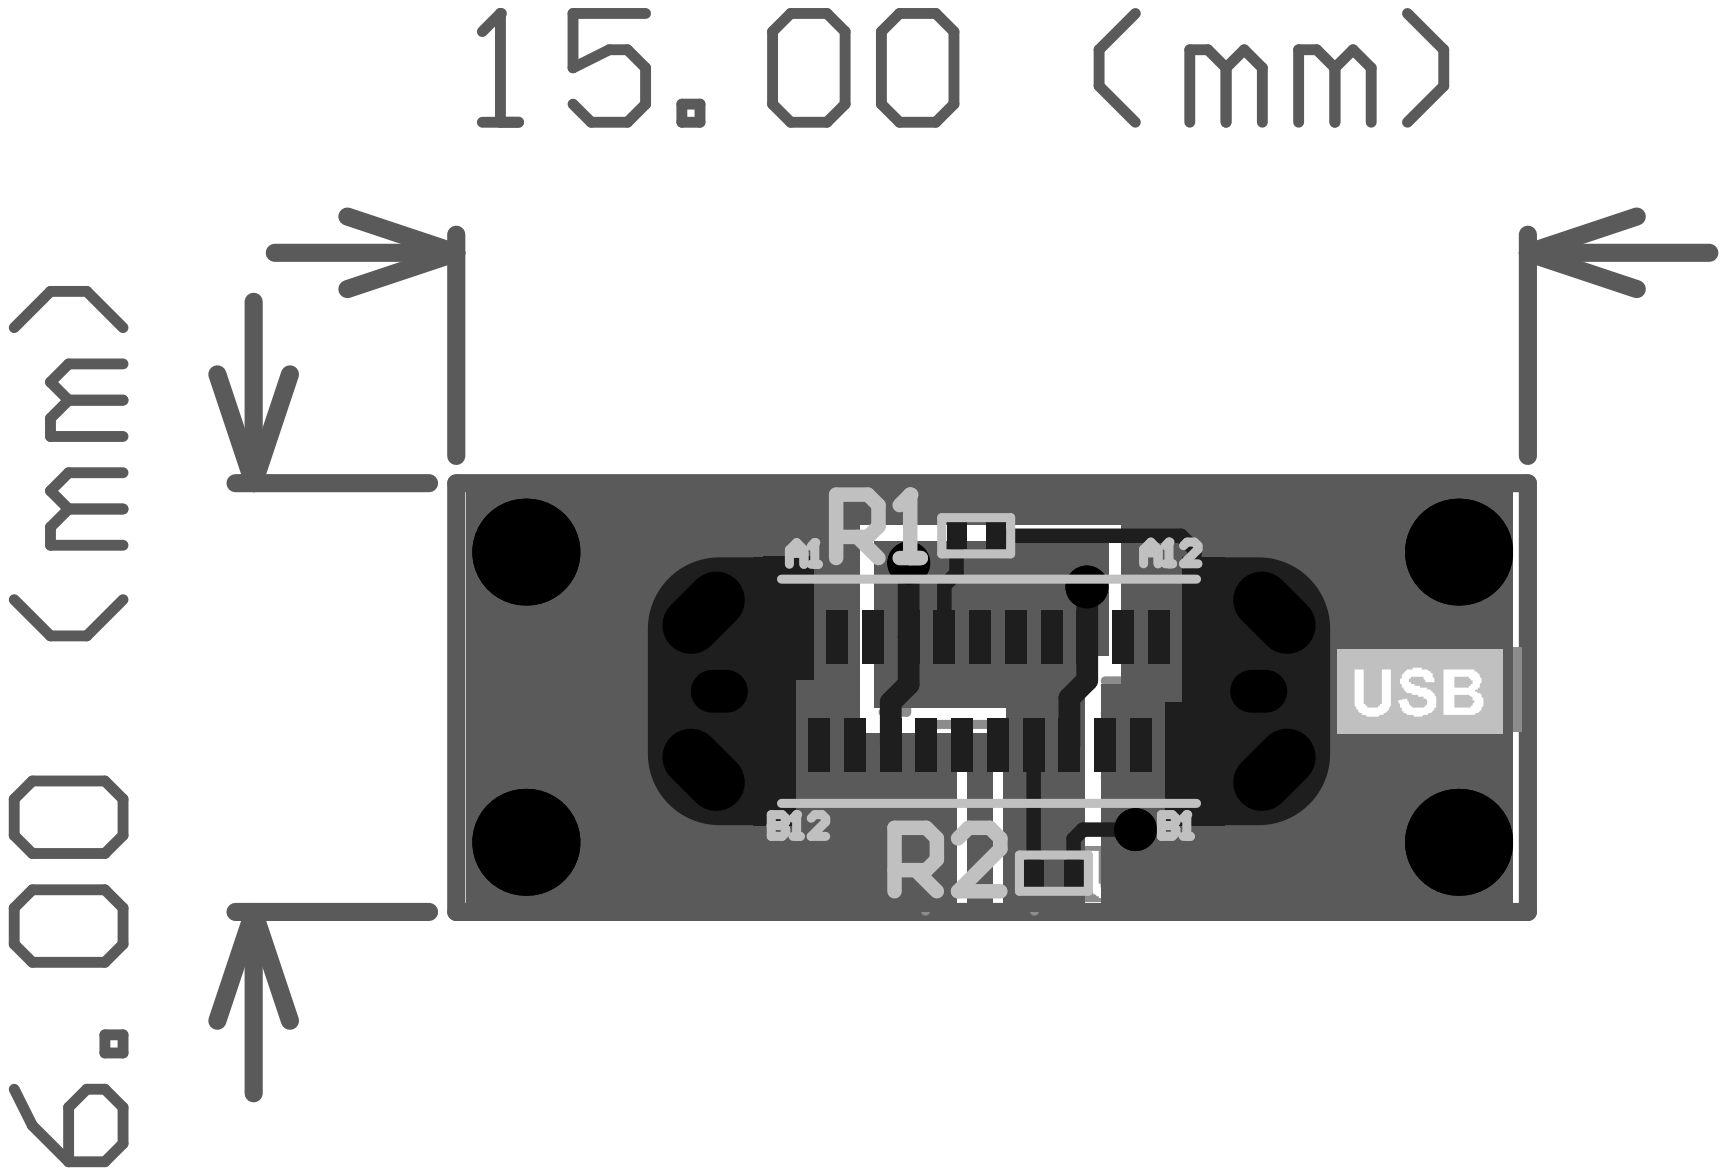
[picture p83: page 3]
