eSpark-Backup/brianperi-smartwatch/(list of files, drawings)

Other design files:
Design-Files/Bracelet(Aux_v1.0)/Bracelet_Aux_v1.0.PcbDoc
Design-Files/Bracelet(Aux_v1.0)/Bracelet_Aux_v1.0.PrjPcb
Design-Files/Bracelet(Aux_v1.0)/Connector_Section.SchDoc
Design-Files/Bracelet(Aux_v1.0)/Top_Sheet.SchDoc
Design-Files/Bracelet(Aux_v2.0)/Bracelet_Aux_v2.0.PcbDoc
Design-Files/Bracelet(Aux_v2.0)/Bracelet_Aux_v2.0.PrjPcb
Design-Files/Bracelet(Aux_v2.0)/Connector_Section.SchDoc
Design-Files/Bracelet(Aux_v2.0)/Top_Sheet.SchDoc
Design-Files/Bracelet(Main)/Battery_Charging_Section.SchDoc
Design-Files/Bracelet(Main)/Bracelet_Main.PcbDoc
Design-Files/Bracelet(Main)/Bracelet_Main.PrjPcb
Design-Files/Bracelet(Main)/Connector_Section.SchDoc
Design-Files/Bracelet(Main)/Controller_Section.SchDoc
Design-Files/Bracelet(Main)/Fast_Charger_Sec.SchDoc
Design-Files/Bracelet(Main)/LED_Power_Sec.SchDoc
Design-Files/Bracelet(Main)/MCU_Power_Sec.SchDoc
Design-Files/Bracelet(Main)/Peripheral_Section.SchDoc
Design-Files/Bracelet(Main)/Power_Section.SchDoc
Design-Files/Bracelet(Main)/Top_Sheet.SchDoc
Library-Files/Brian_.PcbLib
Library-Files/Brian_.SchLib
