eSpark-Backup/brianperi-smartwatch/Documents/Client-Files/Eagle-DesignFiles/Bracelet_PCB_v2.0.brd

## EAGLE design Documents/Client-Files/Eagle-DesignFiles/Bracelet_PCB_v2.0.brd (2021-07-14)

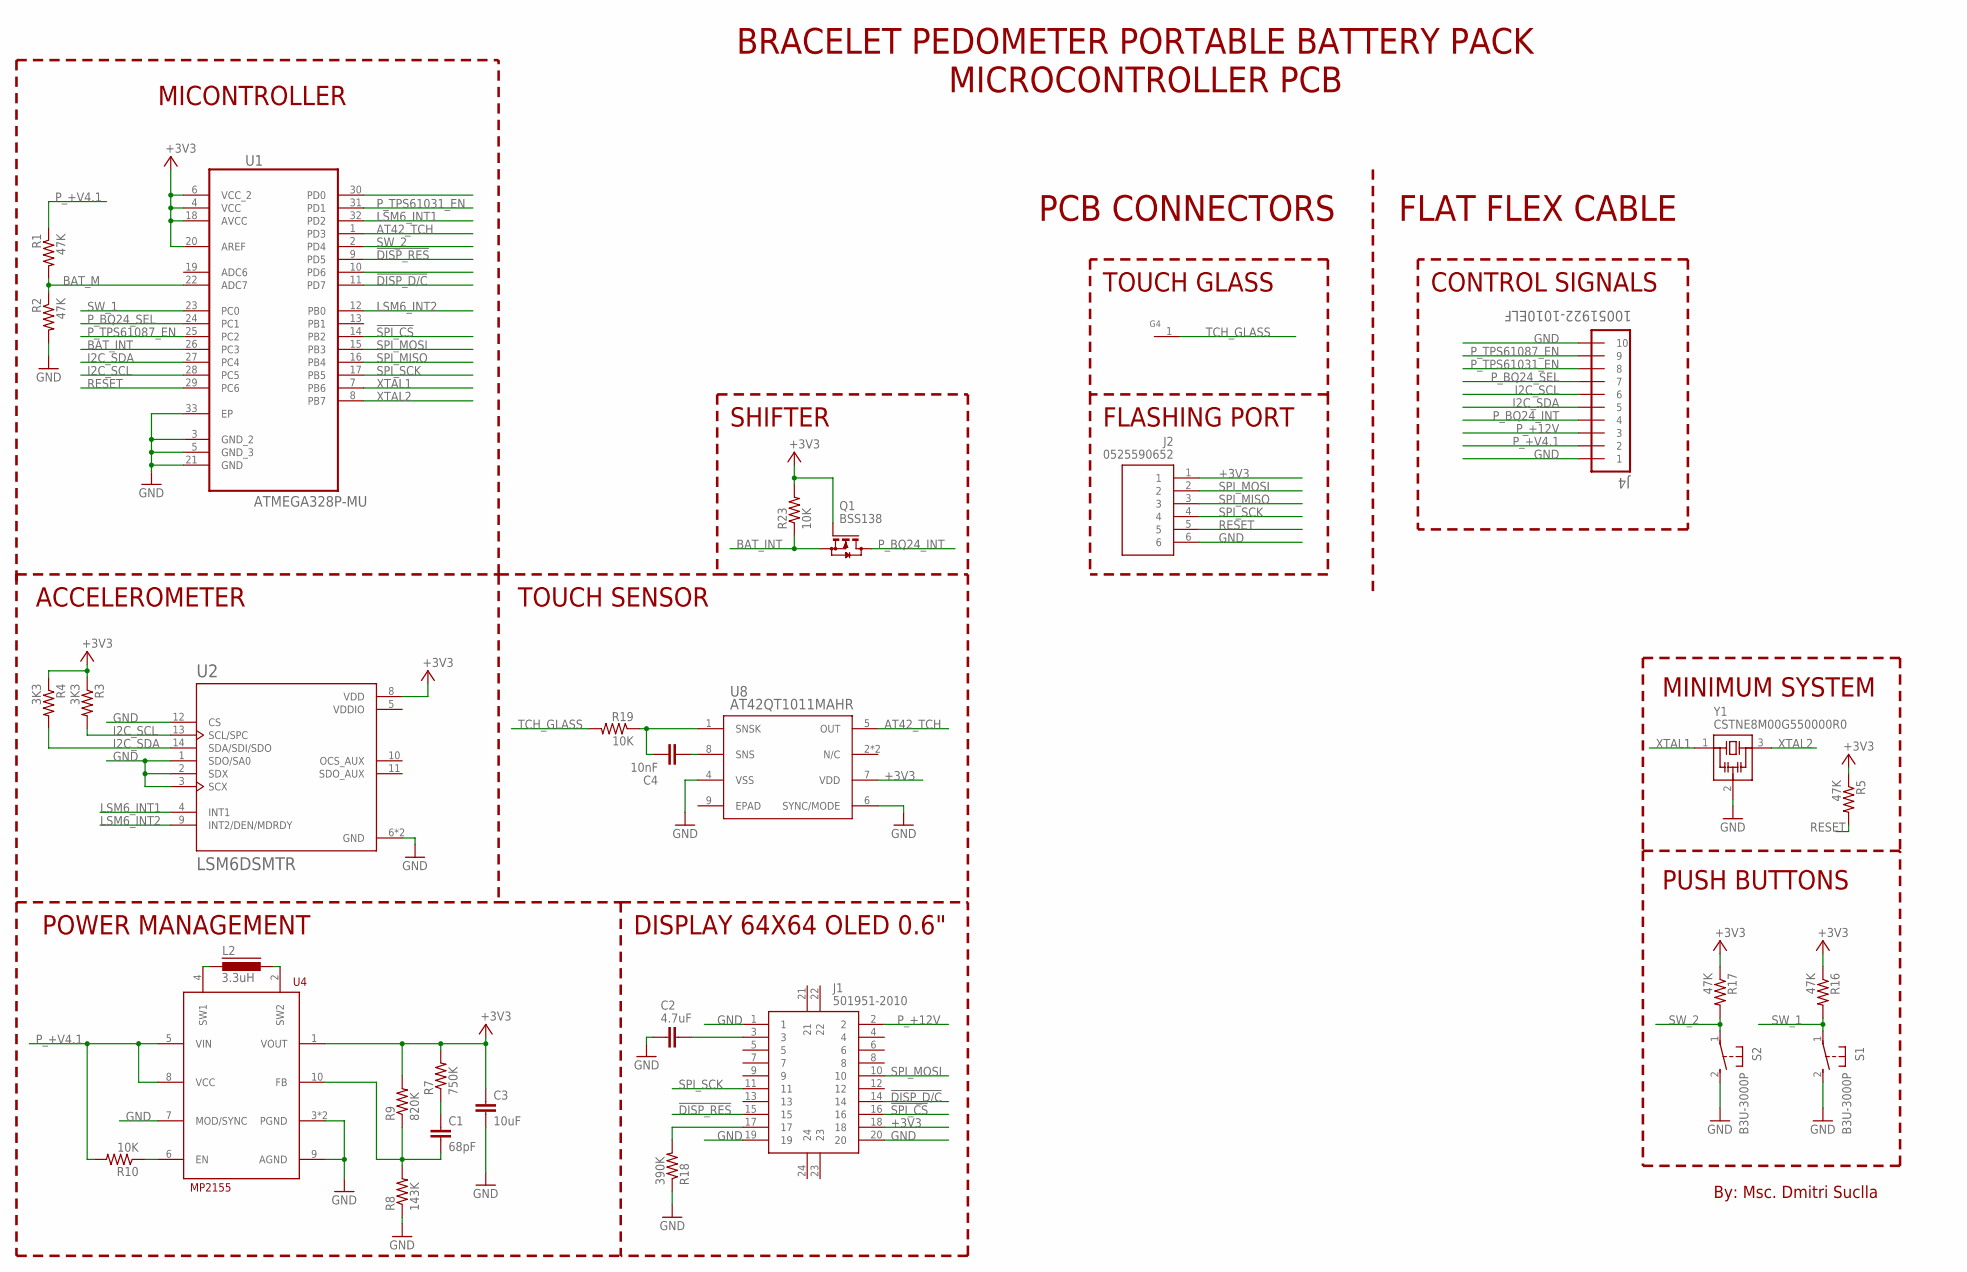
[picture p84: schematic Bracelet_PCB_v2.0.sch, sheet 1]

Parts:
C1: 68pF; C0201; MPN GRM0335C1H680JA01D
C2: 4.7uF; C0402
C3: 10uF; C0603; MPN GRM188R61C106KAALJ
C4: 10nF; C0201; MPN GRM033R61E103MA12D
G4: TOUCH_GLASS
J1: 501951-2010; 5019512010
J2: 0525590652
J4: 10051922-1010ELF; FCI_10051922-1010ELF
L2: 3.3uH; 0603(1608)
Q1: BSS138; SOT23
R1, R2, R5, R16, R17: 47K; R0201
R3, R4: 3K3; R0201
R7: 750K; R0201
R8: 143K; R0201
R9: 820K; R0201
R10, R19: 10K; R0201
R18: 390K; R0201
R23: 10K; R0201; MPN ERJ-1GNF1583C
S1, S2: B3U-3000P; SW_B3U-3000P
U1: ATMEGA328P-MU; QFN50P500X500X100-33N
U2: LSM6DSMTR; PQFN50P300X250X86-14N
U4: MP2155; QFN10
U8: AT42QT1011MAHR; 8-UDFN
Y1: CSTNE8M00G550000R0; CSTNE

Connections:
!DISP_D/C: J1.14, U1.11 (PD7)
!DISP_RES: J1.15, U1.9 (PD5)
!SPI_CS: J1.16, U1.14 (PB2)
+3V3: C3.1, J1.18, J2.1, Q1.1 (G), R3.1, R4.1, R5.1, R7.2, R9.2, R16.1, R17.1, R23.2, U1.4 (VCC), U1.6 (VCC_2), U1.18 (AVCC), U1.20 (AREF), U2.8 (VDD), U4.1 (VOUT), U8.7 (VDD)
AT42_TCH: U1.1 (PD3), U8.5 (OUT)
BAT_INT: Q1.2 (S), R23.1, U1.26 (PC3)
BAT_M: R1.2, R2.1, U1.22 (ADC7)
GND: C2.2, C3.2, J1.1, J1.19, J1.20, J2.6, J4.1, J4.10, R2.2, R8.1, R18.1, S1.2, S2.2, U1.3 (GND_2), U1.5 (GND_3), U1.21 (GND), U1.33 (EP), U2.1 (SDO/SA0), U2.2 (SDX), U2.3 (SCX), U2.6 (GND), U2.7 (GND), U2.12 (CS), U4.3 (PGND), U4.7 (MOD/SYNC), U4.9 (AGND), U4.EP (PGND), U8.4 (VSS), U8.6 (SYNC/MODE), Y1.2 (GND)
I2C_SCL: J4.6, R3.2, U1.28 (PC5), U2.13 (SCL/SPC)
I2C_SDA: J4.5, R4.2, U1.27 (PC4), U2.14 (SDA/SDI/SDO)
LSM6_INT1: U1.32 (PD2), U2.4 (INT1)
LSM6_INT2: U1.12 (PB0), U2.9 (INT2/DEN/MDRDY)
unnamed: C1.1, R7.1
unnamed: C1.2, R8.2, R9.1, U4.10 (FB)
unnamed: L2.2, U4.2 (SW2)
unnamed: L2.1, U4.4 (SW1)
unnamed: C4.1, U8.8 (SNS)
unnamed: C2.1, J1.3
unnamed: C4.2, R19.1, U8.1 (SNSK)
unnamed: R10.1, U4.6 (EN)
unnamed: J1.17, R18.2
P_+12V: J1.2, J4.3
P_+V4.1: J4.2, R1.1, R10.2, U4.5 (VIN), U4.8 (VCC)
P_BQ24_INT: J4.4, Q1.3 (D)
P_BQ24_SEL: J4.7, U1.24 (PC1)
P_TPS61031_EN: J4.8, U1.31 (PD1)
P_TPS61087_EN: J4.9, U1.25 (PC2)
RESET: J2.5, R5.2, U1.29 (PC6)
SPI_MISO: J2.3, U1.16 (PB4)
SPI_MOSI: J1.10, J2.2, U1.15 (PB3)
SPI_SCK: J1.11, J2.4, U1.17 (PB5)
SW_1: R16.2, S1.1, U1.23 (PC0)
SW_2: R17.2, S2.1, U1.2 (PD4)
TCH_GLASS: G4.1, R19.2
VDDIO: U2.5 (VDDIO)
XTAL1: U1.7 (PB6), Y1.1 (IN)
XTAL2: U1.8 (PB7), Y1.3 (OUT)

Notes on the sheet:
By: Msc. Dmitri Suclla
MINIMUM SYSTEM
ACCELEROMETER
POWER MANAGEMENT
DISPLAY 64X64 OLED 0.6"
MICONTROLLER
FLASHING PORT
PUSH BUTTONS
TOUCH SENSOR
BRACELET PEDOMETER PORTABLE BATTERY PACK
MICROCONTROLLER PCB
PCB CONNECTORS
CONTROL SIGNALS
FLAT FLEX CABLE
TOUCH GLASS
SHIFTER

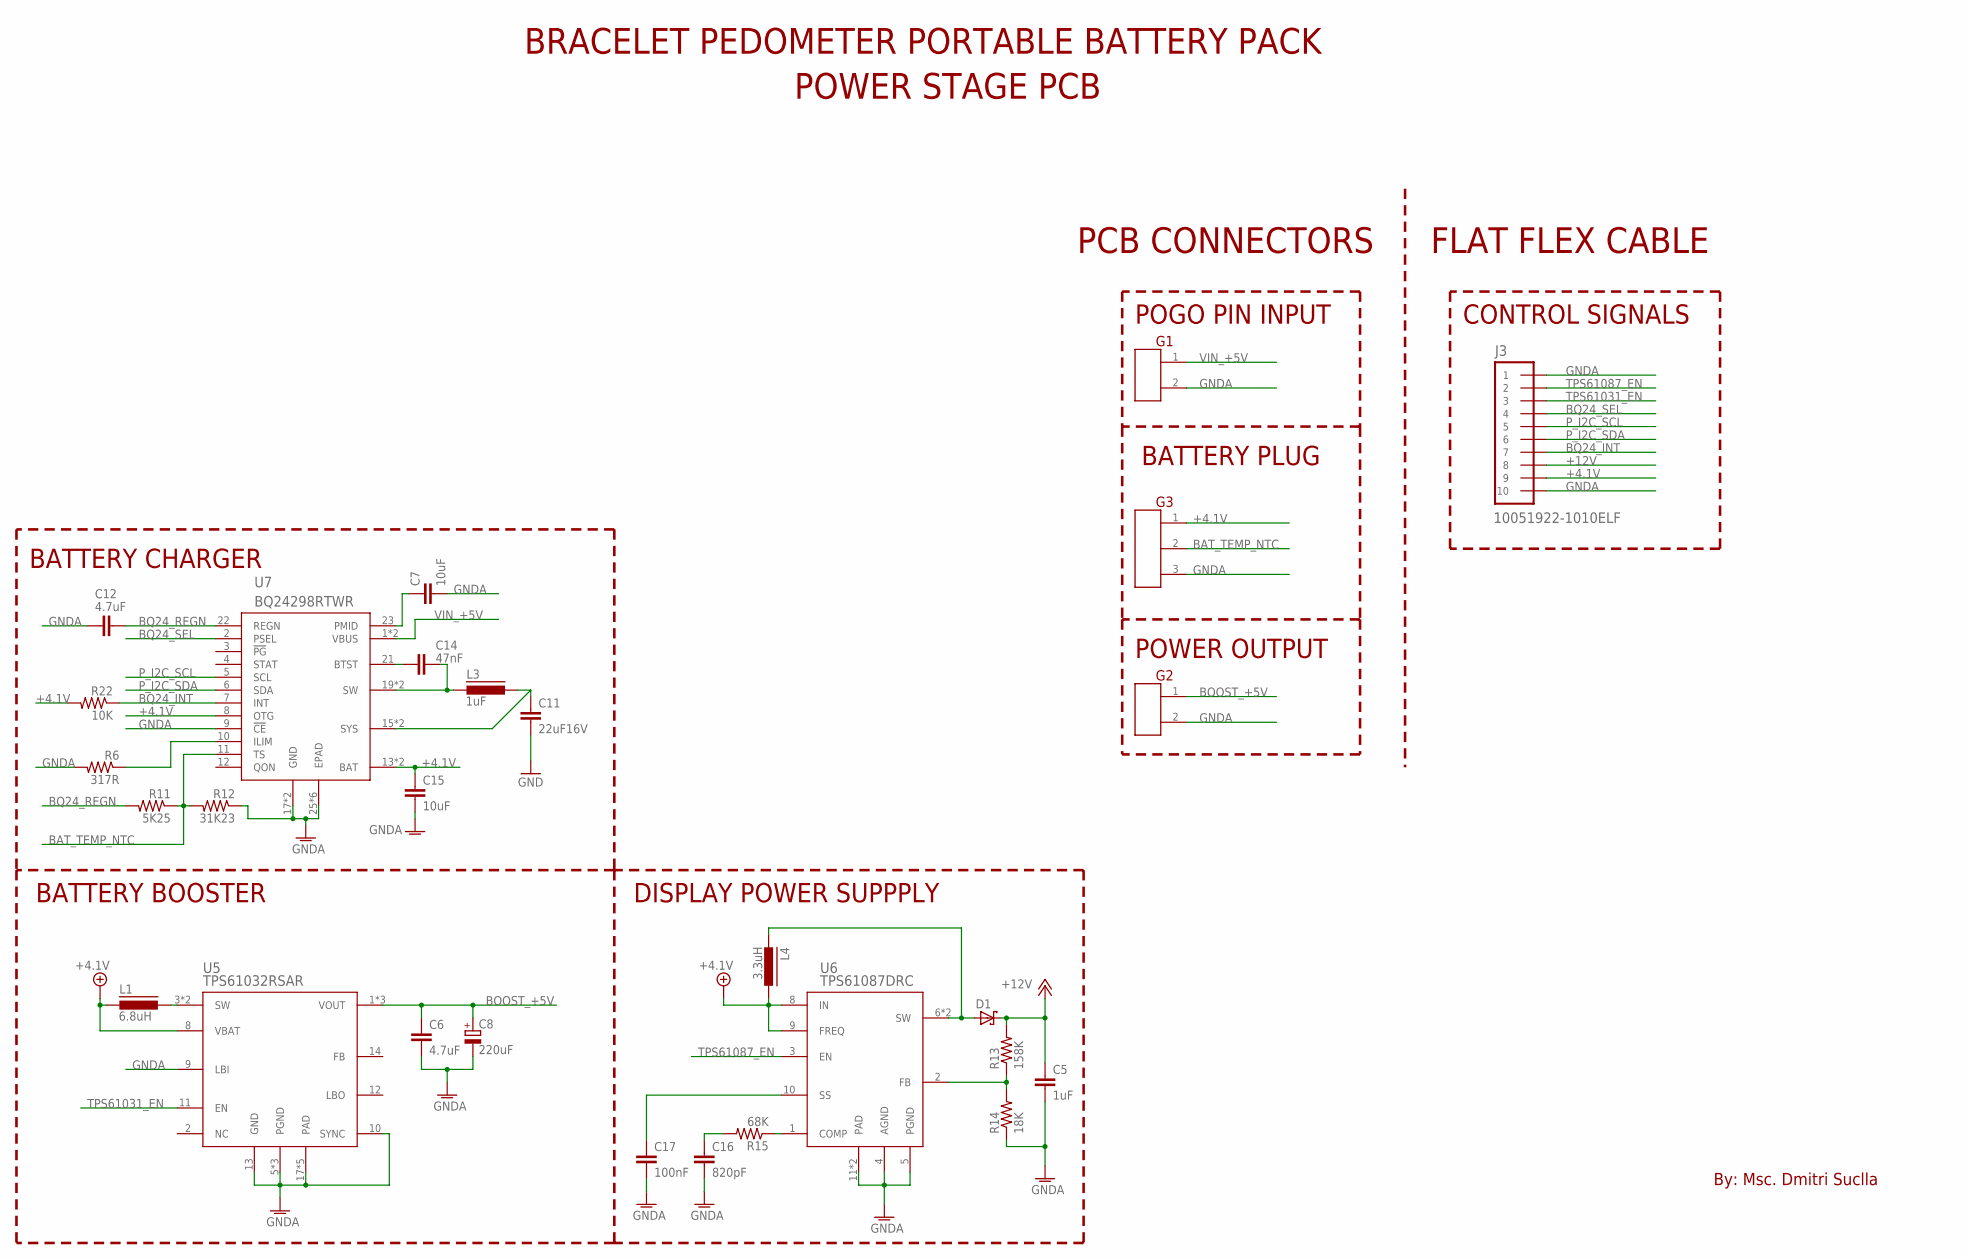
[picture p85: schematic Bracelet_PCB_v2.0.sch, sheet 2]

Parts:
C5: 1uF; C0402; MPN CL05A105KA5NQNC
C6, C12: 4.7uF; C0402
C7, C15: 10uF; C0603; MPN GRM188R61C106KAALJ
C8: 220uF; CT3528; MPN F930J227MBA
C11: 22uF16V; C1206
C14: 47nF; C0201
C16: 820pF; C0201; MPN CL03A104KO3NNNC
C17: 100nF; C0201; MPN CL03A104KO3NNNC
D1: CDBU0245CDBU-M; CDBU-M
G1, G2: PIN_HEADER; PIN_HEADER_2P_1.27MM
G3: PIN_HEADER_3; PIN_HEADER_3P
J3: 10051922-1010ELF; FCI_10051922-1010ELF
L1: 6.8uH; SRP5030
L3: 1uF; DFE252012PD
L4: 3.3uH; 0603(1608)
R6: 317R; R0201
R11: 5K25; R0201
R12: 31K23; R0201
R13: 158K; R0201; MPN ERJ-1GNF1583C
R14: 18K; R0201
R15: 68K; R0201
R22: 10K; R0201
U5: TPS61032RSAR; 16-VQFN; MPN TPS61032RSAR
U6: TPS61087DRC; 10-VSON
U7: BQ24298RTWR; VQFN

Connections:
+4.1V: C15.1, G3.1, J3.9, L1.2 (1), L4.2, R22.2, U5.8 (VBAT), U6.8 (IN), U6.9 (FREQ), U7.8 (OTG), U7.13 (BAT), U7.14 (BAT)
+12V: C5.1, D1.C, J3.8, R13.2
BAT_TEMP_NTC: G3.2, R11.1, R12.2, U7.11 (TS)
BOOST_+5V: C6.1, C8.+, G2.1, U5.1 (VOUT), U5.15 (VOUT), U5.16 (VOUT)
BQ24_INT: J3.7, R22.1, U7.7 (INT)
BQ24_REGN: C12.1, R11.2, U7.22 (REGN)
BQ24_SEL: J3.4, U7.2 (PSEL)
GNDA: C5.2, C6.2, C7.2, C8.-, C11.2, C12.2, C15.2, C16.2, C17.2, G1.2, G2.2, G3.3, J3.1, J3.10, R6.2, R12.1, R14.1, U5.5 (PGND), U5.6 (PGND), U5.7 (PGND), U5.9 (LBI), U5.10 (SYNC), U5.13 (GND), U5.17 (PAD), U5.19 (PAD), U5.20 (PAD), U5.21 (PAD), U5.22 (PAD), U6.4 (AGND), U6.5 (PGND), U6.11 (PAD), U6.Y (PAD), U7.9 (!CE), U7.17 (GND), U7.18 (GND), U7.25 (EPAD), U7.G1 (EPAD), U7.G2 (EPAD), U7.G3 (EPAD), U7.G4 (EPAD), U7.G5 (EPAD)
unnamed: R6.1, U7.10 (ILIM)
unnamed: C14.1, L3.1, U7.19 (SW), U7.20 (SW)
unnamed: C14.2, U7.21 (BTST)
unnamed: C7.1, U7.23 (PMID)
unnamed: D1.A, L4.1, U6.6 (SW), U6.7 (SW)
unnamed: L1.1 (2), U5.3 (SW), U5.4 (SW)
unnamed: R13.1, R14.2, U6.2 (FB)
unnamed: R15.1, U6.1 (COMP)
unnamed: C16.1, R15.2
unnamed: C17.1, U6.10 (SS)
unnamed: C11.1, L3.2, U7.15 (SYS), U7.16 (SYS)
P_I2C_SCL: J3.5, U7.5 (SCL)
P_I2C_SDA: J3.6, U7.6 (SDA)
TPS61031_EN: J3.3, U5.11 (EN)
TPS61087_EN: J3.2, U6.3 (EN)
VIN_+5V: G1.1, U7.1 (VBUS), U7.24 (VBUS)

Notes on the sheet:
BATTERY CHARGER
BATTERY BOOSTER
DISPLAY POWER SUPPPLY
POGO PIN INPUT
BATTERY PLUG
BRACELET PEDOMETER PORTABLE BATTERY PACK
POWER STAGE PCB
PCB CONNECTORS
CONTROL SIGNALS
By: Msc. Dmitri Suclla
FLAT FLEX CABLE
POWER OUTPUT

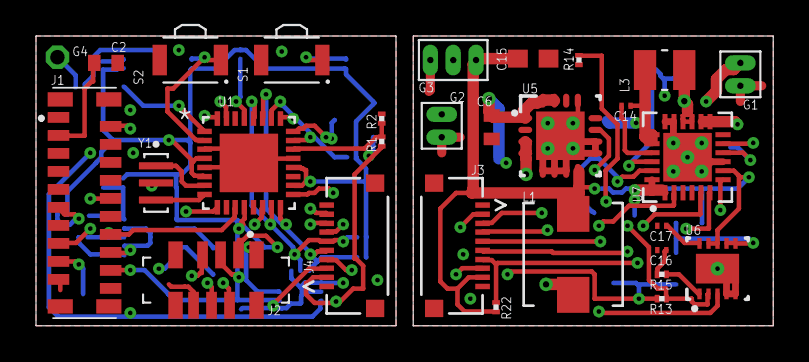
[picture p86: board Bracelet_PCB_v2.0.brd from above]

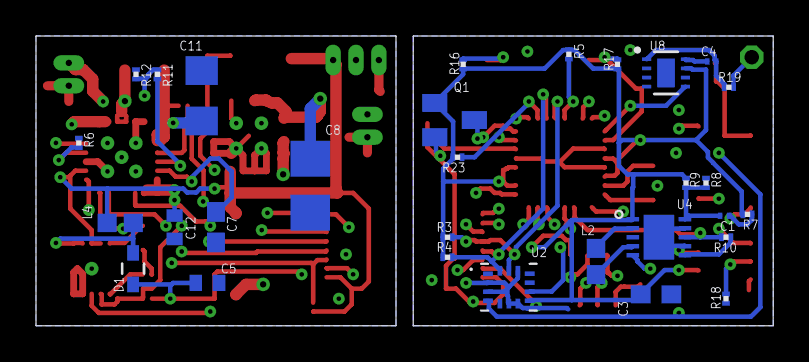
[picture p87: board Bracelet_PCB_v2.0.brd from below]

Board: 4 copper layers, 41.0 x 16.1 mm, 59 parts (30 on the bottom side), 60 nets.
