eSpark-Backup/brianperi-smartwatch/(commit log)

2021-07-14 Latest Files and Deliverables
    [Aux_PCB.GBL, Aux_PCB.GBO, Aux_PCB.GBP, Aux_PCB.GBS, Aux_PCB.GTL, Aux_PCB.GTO, Aux_PCB.GTP, Aux_PCB.GTS]
2021-07-15 Latest Design Files and Deliverables of All PCBs
    [Aux_PCB.GBL, Aux_PCB.GBO, Aux_PCB.GBP, Aux_PCB.GBS, Aux_PCB.GTL, Aux_PCB.GTO, Aux_PCB.GTP, Aux_PCB.GTS]
2021-07-15 Latest BOM Main PCB Digikey or LCSC
    BOM me changes baqi han abi kuch parts ki quotation local supplier se ni ayi abi is lye
    [Brac_PCB(Digikey).xlsx, Brac_PCB(LCSC).xlsx, Bracelet_Main PCB-(LSCS).xlsx, Bracelet_Main-PCB(Digikey).xlsx]
